perigoso/haptic-control/README.md

# haptic-control

PCB designed for (Someone else's) masters degree final project in eletrical-engineering

Made in the context of a research internship at IPL (Polytechnic Institute of Leiria)

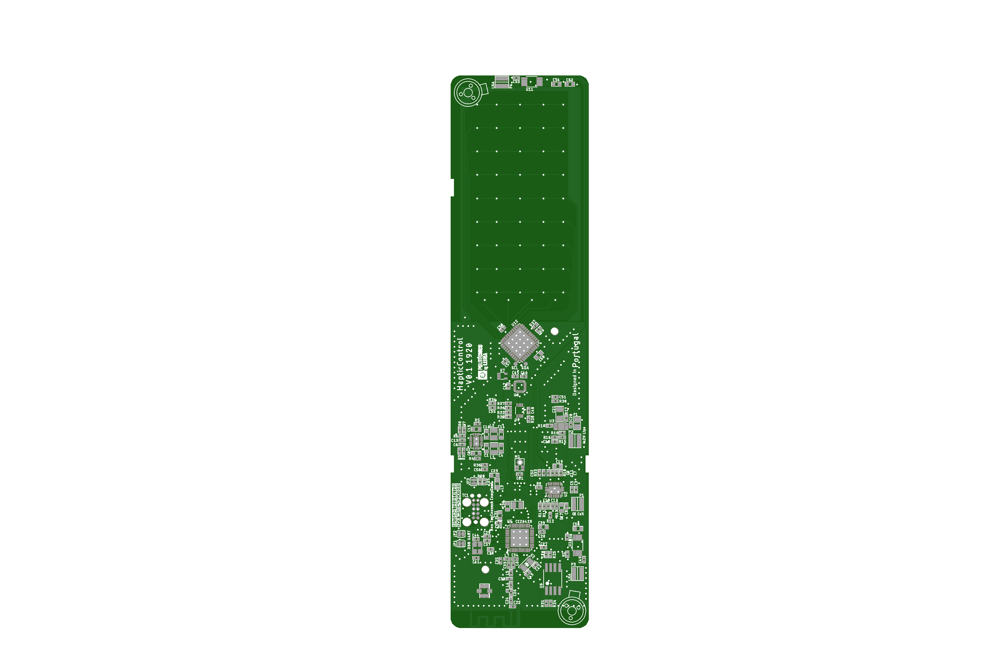
[picture p1: pcb/haptic-control-bot.png]


## Authors

- Rafael Silva
- João Silva
