perigoso/haptic-control/documentation/Screenshot_20190508_003053.png

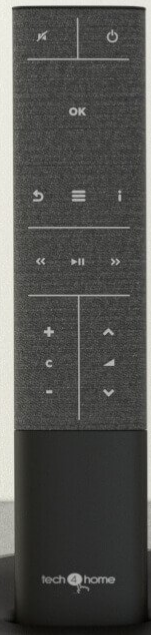
documentation/Screenshot_20190508_003053.png
