perigoso/haptic-control/pcb/haptic-control-top.png

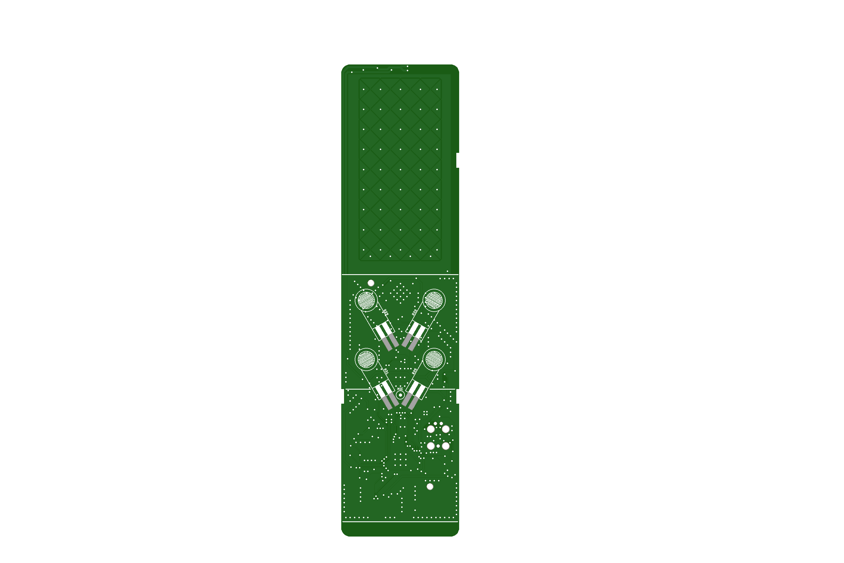
pcb/haptic-control-top.png
