perigoso/haptic-control/pcb/haptic-control-bom.xlsx

Sheet: Sheet1
Device | value | Package | Parts | Notes | Manufacturer | Sample Available | RoHS | REACH/SVHC | Lifecycle | Reference | Link | Qty / Board | Qty | Price(1) | Price(10) | Price(100) | Board price estimate(1) | Board price estimate(100) | Bom Price
capacitor | 100n | _0402 | C3, C20, C25, C27, C28, C29, C32, C37, C38, C40, C45, C46, C47, C48, C49, C53, C57, C58, C59, C61 | Decouple capacitors | Murata Electronics | n |  |  | Active | GCM155R71E104KE02D | https://eu.mouser.com/ProductDetail/Murata-Electronics/GCM155R71E104KE02D | 20 | 100 | 0.087 | 0.058 | 0.025 | 1.74 | 0.5 | 2.5
capacitor | 100u | _1206 | C21 | Bulk capacitor | Murata Electronics | n |  |  | Active | GRM31CD80J107ME39L | https://eu.mouser.com/ProductDetail/Murata-Electronics/GRM31CD80J107ME39L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 | 1 | 10 | 0.603 | 0.445 | 0.305 | 0.603 | 0.305 | 4.45
capacitor | 10n | _0402 | C7, C8 |  | Murata Electronics | n |  |  | Active | GCM155R71H103JA55J | https://eu.mouser.com/ProductDetail/Murata-Electronics/GCM155R71H103JA55J | 2 | 100 | 0.087 | 0.042 | 0.018 | 0.174 | 0.036 | 1.8
capacitor | 10u | _0603 | C60, C62 |  | Murata Electronics | n |  |  | Active | GRM188R60J106KE47D | https://eu.mouser.com/ProductDetail/Murata-Electronics/GRM188R60J106KE47D | 9 | 100 | 0.157 | 0.114 | 0.058 | 1.413 | 0.522 | 5.8
capacitor | 12p | _0402 | C35, C42, C43, C26 |  | Murata Electronics | n |  |  | Active | GCM1555C1H120JA16J | https://eu.mouser.com/ProductDetail/Murata-Electronics/GCM1555C1H120JA16J | 4 | 100 | 0.087 | 0.059 | 0.025 | 0.348 | 0.1 | 2.5
capacitor | 1n | _0402 | C5 |  | Murata Electronics | n |  |  | Active | GCM155R71H102JA37D | https://eu.mouser.com/ProductDetail/Murata-Electronics/GCM155R71H102JA37D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 | 1 | 100 | 0.087 | 0.039 | 0.017 | 0.087 | 0.017 | 1.7
capacitor | 1p | _0402 | C30, C33, C34 |  | Murata Electronics | n |  |  | Active | GCM1555C1H1R0JA16D | https://eu.mouser.com/ProductDetail/Murata-Electronics/GCM1555C1H1R0JA16D | 3 | 100 | 0.087 | 0.049 | 0.021 | 0.261 | 0.063 | 2.1
capacitor | 1p8 | _0402 | C24 |  | Murata Electronics | n |  |  | NRND | GRM1555C1E1R8BA01D | https://eu.mouser.com/ProductDetail/Murata-Electronics/\GRM1555C1E1R8BA01D?qs=sGAEpiMZZMs0AnBnWHyRQO3lCa4gsPOhwIirR49BN2M%3D | 1 | 100 | 0.087 | 0.056 | 0.024 | 0.087 | 0.024 | 2.4
capacitor | 1u | _0603 | C1, C16, C39, C50, C54 |  | Murata Electronics | n |  |  | NRND | GRM188R61A105MA61D | https://eu.mouser.com/ProductDetail/Murata-Electronics/GRM188R61A105MA61D | 5 | 100 | 0.096 | 0.065 | 0.027 | 0.48 | 0.135 | 2.7
capacitor | 22n | _0402 | C9, C10 |  | Murata Electronics | n |  |  | Active | GCM155R71E223JA55D | https://eu.mouser.com/ProductDetail/Murata-Electronics/GCM155R71E223JA55D | 2 | 100 | 0.087 | 0.049 | 0.021 | 0.174 | 0.042 | 2.1
capacitor | 22u | _0603 | C23, C31, C36 |  | Murata Electronics | n |  |  | Active | GRM188R60J226MEA0D | https://eu.mouser.com/ProductDetail/Murata-Electronics/GRM188R60J226MEA0D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 | 3 | 10 | 0.253 | 0.17 | 0.096 | 0.759 | 0.288 | 1.7
capacitor | 470n | _0402 | C11, C12 |  | Murata Electronics | n |  |  | NRND | GRM155R71A474KE01D | https://eu.mouser.com/ProductDetail/Murata-Electronics/GRM155R71A474KE01D | 2 | 100 | 0.087 | 0.071 | 0.031 | 0.174 | 0.062 | 3.1
capacitor | 470p | _0402 | C6, C13, C18, C51, C52, C55, C56 |  | Murata Electronics | n |  |  | Active | GCM155R71H471MA37D | https://eu.mouser.com/ProductDetail/Murata-Electronics/GCM155R71H471MA37D | 7 | 100 | 0.087 | 0.031 | 0.013 | 0.609 | 0.091 | 1.3
connector | ufl | _U.FL | A1 | U.FL | TE Connectivity | n |  |  | Active | 2337019-1 | https://eu.mouser.com/ProductDetail/TE-Connectivity/2337019-1 | 1 | 3 | 0.166 | 0.134 | 0.106 | 0.166 | 0.106 | 0.498
crystal | 32.768kHz | _3215 | X2 |  | Epson Timing | n |  |  |  | FC-135 32.7680KA-AG0 | https://eu.mouser.com/ProductDetail/Epson-Timing/FC-135-327680KA-AG0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 | 1 | 3 | 0.332 | 0.273 | 0.246 | 0.332 | 0.246 | 0.996
crystal | 48MHz | _3225 | X1 |  | Kyocera Electronic Components | n |  |  |  | CX2016DB48000C0FPLC1 | https://eu.mouser.com/ProductDetail/Kyocera-Electronic-Components/CX2016DB48000C0FPLC1 | 1 | 3 | 0.594 | 0.528 | 0.437 | 0.594 | 0.437 | 1.782
fsr | FSR400 | - | R29, R31, R33, R35 | FSR400-SHORT-TAIL | - | n |  |  | - | FSR400-SHORT-TAIL | - | 4 | 12 | - | - | -
inductor | 1u | _0806 | L1, L2 | Buck Inductors | Taiyo Yuden | n |  |  | Active | MAKK2016H1R0M | https://eu.mouser.com/ProductDetail/Taiyo-Yuden/MAKK2016H1R0M | 2 | 6 | 0.236 | 0.155 | 0.155 | 0.472 | 0.31 | 1.416
inductor | 2n | _0402 | L4, L5 | unshielded | TDK | n |  |  | Active | MLG1005S2N0CT000 | https://eu.mouser.com/ProductDetail/TDK/MLG1005S2N0CT000 | 2 | 6 | 0.087 | 0.038 | 0.034 | 0.174 | 0.068 | 0.522
inductor | 2n4 | _0402 | L6, L7 | unshielded | TDK | n |  |  | Active | MLG1005S2N4BT000 | https://eu.mouser.com/ProductDetail/TDK/MLG1005S2N4BT000 | 2 | 6 | 0.087 | 0.038 | 0.035 | 0.174 | 0.07 | 0.522
inductor | 6u8 | _0806 | L8 | MCU Core Buck Inductor | Taiyo Yuden | n |  |  | Active | BRC2016T6R8M | https://eu.mouser.com/ProductDetail/Taiyo-Yuden/BRC2016T6R8M | 1 | 3 | 0.271 | 0.182 | 0.151 | 0.271 | 0.151 | 0.813
filter | BLM18HE152SN1 | _0603 | L3 |  | Murata Electronics | n |  |  | Active | BLM18HE152SN1D | https://eu.mouser.com/ProductDetail/Murata-Electronics/BLM18HE152SN1D | 1 | 3 | 0.183 | 0.108 | 0.076 | 0.183 | 0.076 | 0.549
bat management | AP9211 | DFN2030-6 | U3 | battery prottection | Diodes Incorporated | n |  |  | Active | AP9211SA-AE-HAC-7 | https://eu.mouser.com/ProductDetail/Diodes-Incorporated/AP9211SA-AE-HAC-7 | 1 | 3 | 0.568 | 0.472 | 0.304 | 0.568 | 0.304 | 1.704
pptc | pptc | _0805 | F1 | 500mA trip current | Bel Fuse | n |  |  | Active | 0ZCK0020FF2G | https://eu.mouser.com/ProductDetail/Bel-Fuse/0ZCK0020FF2G | 1 | 3 | 0.122 | 0.117 | 0.081 | 0.122 | 0.081 | 0.366
resistor | 330 | _0402 | R17 | 5% | Yageo | n |  |  | Active | RC0402JR-13330RL | https://eu.mouser.com/ProductDetail/Yageo/RC0402JR-13330RL?qs=sGAEpiMZZMvdGkrng054tyXF6wqYTHOH6gUR5MIH6C8%3D | 1 | 100 | 0.087 | 0.009 | 0.003 | 0.087 | 0.003 | 0.3
resistor | 100k | _0402 | R1, R4, R5, R6, R10, R13, R15, R20, R21, R24, R25, R37, R38 | pull up resistors ( & vbat divider) 1% | Yageo | n |  |  | Active | RC0402FR-07100KL | https://eu.mouser.com/ProductDetail/Yageo/RC0402FR-07100KL?qs=sGAEpiMZZMvdGkrng054txdMlaQGj9fiWeFAEYA7478%3D | 13 | 100 | 0.087 | 0.01 | 0.003 | 1.131 | 0.039 | 0.3
resistor | 10M | _0402 | R19 | 5% | Yageo | n |  |  | Active | RC0402FR-0710ML | https://eu.mouser.com/ProductDetail/Yageo/RC0402FR-0710ML?qs=sGAEpiMZZMvdGkrng054t3wEnozbAaaSWWfsCSN2eSk%3D | 1 | 100 | 0.087 | 0.01 | 0.003 | 0.087 | 0.003 | 0.3
resistor | 10k | _0402 | R14 | QI Charger NTC bypass 5% | Yageo | n |  |  | Active | RC0402JR-7W10KL | https://eu.mouser.com/ProductDetail/Yageo/RC0402JR-7W10KL | 1 | 100 | 0.087 | 0.01 | 0.003 | 0.087 | 0.003 | 0.3
resistor | 140 | _0402 | R12 | 1% | Yageo | n |  |  | Active | RC0402FR-07140RL | https://eu.mouser.com/ProductDetail/Yageo/RC0402FR-07140RL?qs=sGAEpiMZZMvdGkrng054t8AJgcdMkx7xLGg9K55Kjt4%3D | 1 | 100 | 0.087 | 0.01 | 0.003 | 0.087 | 0.003 | 0.3
resistor | 158k | _0402 | R8 | 1% | Yageo | n |  |  | Active | RC0402FR-07158KL | https://eu.mouser.com/ProductDetail/Yageo/RC0402FR-07158KL | 1 | 100 | 0.087 | 0.01 | 0.003 | 0.087 | 0.003 | 0.3
resistor | 2k7 | _0402 | R18 | 1% | Yageo | n |  |  | Active | RC0402FR-072K7L | https://eu.mouser.com/ProductDetail/Yageo/RC0402FR-072K7L?qs=sGAEpiMZZMvdGkrng054t8AJgcdMkx7xEULkXzel7Wo%3D | 1 | 100 | 0.087 | 0.01 | 0.003 | 0.087 | 0.003 | 0.3
resistor | 1k2 | _0402 | R11 | 1% | Yageo | n |  |  | Active | AC0402FR-071K2L | https://eu.mouser.com/ProductDetail/Yageo/AC0402FR-071K2L?qs=sGAEpiMZZMvdGkrng054t1dXgLbs7QPXYJaSyzoIyoA%3D | 1 | 100 | 0.087 | 0.01 | 0.003 | 0.087 | 0.003 | 0.3
resistor | 200k | _0402 | R28 | 5% | Yageo | n |  |  | Active | RC0402FR-07200KL | https://eu.mouser.com/ProductDetail/Yageo/RC0402FR-07200KL | 1 | 100 | 0.087 | 0.01 | 0.003 | 0.087 | 0.003 | 0.3
resistor | 2k43 | _0402 | R9 | 1% | Yageo | n |  |  | Active | RC0402FR-072K43L | https://eu.mouser.com/ProductDetail/Yageo/RC0402FR-072K43L?qs=sGAEpiMZZMvdGkrng054txdMlaQGj9fiVaCQFdFcUTs%3D | 1 | 100 | 0.087 | 0.01 | 0.003 | 0.087 | 0.003 | 0.3
resistor | 3k4 | _0402 | R30, R32, R34, R36 | 1% | Yageo | n |  |  | Active | RC0402FR-073K4L | https://eu.mouser.com/ProductDetail/Yageo/RC0402FR-073K4L?qs=sGAEpiMZZMvdGkrng054t8AJgcdMkx7xgpEjmeLAGq8%3D | 4 | 100 | 0.087 | 0.01 | 0.003 | 0.348 | 0.012 | 0.3
resistor | 301k | _0402 | R7 | 1% | Yageo | n |  |  | Active | RC0402FR-07301KL | https://eu.mouser.com/ProductDetail/Yageo/RC0402FR-07301KL | 1 | 100 | 0.087 | 0.01 | 0.003 | 0.087 | 0.003 | 0.3
resistor | 309k | _0402 | R2 | 1% | Yageo | n |  |  | Active | RC0402FR-07309KL | https://eu.mouser.com/ProductDetail/Yageo/RC0402FR-07309KL | 1 | 100 | 0.087 | 0.01 | 0.003 | 0.087 | 0.003 | 0.3
resistor | 49k9 | _0402 | R16 | 1% | Yageo | n |  |  | Active | RC0402FR-0749K9L | https://eu.mouser.com/ProductDetail/Yageo/RC0402FR-0749K9L | 1 | 100 | 0.087 | 0.01 | 0.003 | 0.087 | 0.003 | 0.3
resistor | 4k7 | _0402 | R22, R23, R26, R27 | i2C pullups 5% | Yageo | n |  |  | Active | RC0402JR-074K7L | https://eu.mouser.com/ProductDetail/Yageo/RC0402JR-074K7L | 4 | 100 | 0.087 | 0.01 | 0.003 | 0.348 | 0.012 | 0.3
resistor | 71k5 | _0402 | R3 | 1% | Yageo | n |  |  | Active | RC0402FR-0771K5L | https://eu.mouser.com/ProductDetail/Yageo/RC0402FR-0771K5L?qs=sGAEpiMZZMvdGkrng054t8AJgcdMkx7xnOhPQVwMv9Y%3D | 1 | 100 | 0.087 | 0.01 | 0.003 | 0.087 | 0.003 | 0.3
touch controller | MTCH6301 | QFN44 | U12 | touch matrix controller | Microchip Technology | y |  |  | Active | MTCH6301-I/ML | https://eu.mouser.com/ProductDetail/Microchip-Technology/MTCH6301-I-ML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 | 1 | 3 | 2.51 | 2.47 | 2.08 | 2.51 | 2.08 | 7.53
qi charger ic | BQ51050B | VQFN20 | U2 |  | Texas Instruments | n |  |  | Active | BQ51050BRHLR | https://eu.mouser.com/ProductDetail/Texas-Instruments/BQ51050BRHLR | 1 | 0 | 3.26 | 2.93 | 2.39 | 3.26 | 2.39 | 0
mpu | ICM20948 | QFN20 | U8 |  | TDK InvenSense | n |  |  | Active | ICM-20948 | https://eu.mouser.com/ProductDetail/TDK-InvenSense/ICM-20948 | 1 | 3 | 6.65 | 5.41 | 3.3 | 6.65 | 3.3 | 19.95
mcu | CC2642R | QFN48 | U5 |  | Texas Instruments | n |  |  | Active | CC2642R1FRGZR | https://eu.mouser.com/ProductDetail/Texas-Instruments/CC2642R1FRGZT | 1 | 0 | 5.62 | 5.08 | 4.2 | 5.62 | 4.2 | 0
logic gate | 74LVC1G17 | SC70-5 | U7 |  | Nexperia | n |  |  | Active | 74LVC1G17GV | https://eu.mouser.com/ProductDetail/Nexperia/74LVC1G17GV125?qs=sGAEpiMZZMutXGli8Ay4kDE4J8KCiPsFe3SZlXnQs3A%3D | 1 | 3 | 0.253 | 0.175 | 0.073 | 0.253 | 0.073 | 0.759
microphone | SPH0641LM4H-1 | - | M1 | SPH0641LM4H-1 | Knowles | n |  |  | Active | SPH0641LM4H-1 | https://eu.mouser.com/ProductDetail/Knowles/SPH0641LM4H-1 | 1 | 3 | 0.996 | 0.789 | 0.625 | 0.996 | 0.625 | 2.988
i2c level translator | PCA9306 | VSSOP8 | U9 | PCA9306-DCU | Texas Instruments | n |  |  | Active | PCA9306DCUR | https://eu.mouser.com/ProductDetail/Texas-Instruments/PCA9306DCUR | 1 | 0 | 0.576 | 0.477 | 0.307 | 0.576 | 0.307 | 0
driver | DRV2605L | VSSOP10 | U10, U11 |  | Texas Instruments | n |  |  | Active | DRV2605LYZFR | https://eu.mouser.com/ProductDetail/Texas-Instruments/DRV2605LYZFR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 | 2 | 6 | 2.54 | 2.29 | 1.87 | 5.08 | 3.74 | 15.24
buck | MIC23159 | VQFN20 | U1 |  | Microchip Technology / Micrel | y |  |  | Active | MIC23158YML-T5 | https://eu.mouser.com/ProductDetail/Microchip-Technology-Micrel/MIC23158YML-T5 | 1 | 3 | 1.94 | 1.91 | 1.47 | 1.94 | 1.47 | 5.82
flash | 8Mbit | WSOIC8 | U6 |  | Winbond |  |  |  | Active | W25Q80DVSSIG | https://eu.mouser.com/ProductDetail/Winbond/W25Q80DVSSIG | 1 | 3 | 0.367 | 0.362 | 0.298 | 0.367 | 0.298 | 1.101
 |  |  |  |  |  |  |  |  |  |  |  |  |  |  |  |  | Total: | Total: | Total:
 |  |  |  |  |  |  |  |  |  |  |  |  |  |  |  |  | 40.175 | 22.619 | 101.506
 |  |  |  |  |  | y

Sheet: Sheet2
Device | value | Package | Parts
capacitor | 100n | _0402 | C3, C20, C25, C27, C28, C29, C32, C37, C38, C40, C45, C46, C47, C48, C49, C53, C57, C58, C59, C61
capacitor | 100u | _1206 | C21
capacitor | 10n | _0402 | C7, C8
capacitor | 10u | _0603 | C60, C62
capacitor | 12p | _0402 | C35, C42, C43, C26
capacitor | 1n | _0402 | C5
capacitor | 1p | _0402 | C30, C33, C34
capacitor | 1p8 | _0402 | C24
capacitor | 1u | _0603 | C1, C16, C39, C50, C54
capacitor | 22n | _0402 | C9, C10
capacitor | 22u | _0603 | C23, C31, C36
capacitor | 470n | _0402 | C11, C12
capacitor | 470p | _0402 | C6, C13, C18, C51, C52, C55, C56
connector | ufl | _U.FL | A1
crystal | 32.768kHz | _3215 | X2
crystal | 48MHz | _3225 | X1
fsr | FSR400 | - | R29, R31, R33, R35
inductor | 1u | _0806 | L1, L2
inductor | 2n | _0402 | L4, L5
inductor | 2n4 | _0402 | L6, L7
inductor | 6u8 | _0806 | L8
filter | BLM18HE152SN1 | _0603 | L3
bat management | AP9211 | DFN2030-6 | U3
pptc | pptc | _0805 | F1
resistor | 330 | _0402 | R17
resistor | 100k | _0402 | R1, R4, R5, R6, R10, R13, R15, R20, R21, R24, R25, R37, R38
resistor | 10M | _0402 | R19
resistor | 10k | _0402 | R14
resistor | 140 | _0402 | R12
resistor | 158k | _0402 | R8
resistor | 2k7 | _0402 | R18
resistor | 1k2 | _0402 | R11
resistor | 200k | _0402 | R28
resistor | 2k43 | _0402 | R9
resistor | 3k4 | _0402 | R30, R32, R34, R36
resistor | 301k | _0402 | R7
resistor | 309k | _0402 | R2
resistor | 49k9 | _0402 | R16
resistor | 4k7 | _0402 | R22, R23, R26, R27
resistor | 71k5 | _0402 | R3
touch controller | MTCH6301 | QFN44 | U12
qi charger ic | BQ51050B | VQFN20 | U2
mpu | ICM20948 | QFN20 | U8
mcu | CC2642R | QFN48 | U5
logic gate | 74LVC1G17 | SC70-5 | U7
microphone | SPH0641LM4H-1 | - | M1
i2c level translator | PCA9306 | VSSOP8 | U9
driver | DRV2605L | VSSOP10 | U10, U11
buck | MIC23159 | VQFN20 | U1
flash | 8Mbit | WSOIC8 | U6
