perigoso/haptic-control/documentation/WCS037B/BOM/WCS037B_BOM.xlsx

Design Modify Date = Tuesday, July 10, 2018
RevCode = B
Title = LAUNCHXL-CC26X2R1
Part Number | Quantity | Part Reference | Value | Description | Vendor | Vendor Part Number | ROHS | REACH/SVHC Compliance
02-07617 | 8 | C1 C9 C14 C17 C18 C31 C88 C89 | 12pF | CAPACITOR, CERAMIC C0G/NP0, 12pF, 50V, -5%/+5%, -55DEGC/+125DEGC, 0402, SMD | MURATA | GRM1555C1H120JA01D | Compliant | Compliant
02-07775 | 8 | C2 C3 C4 C7 C50 C109 C166 C484 | 10nF | CAPACITOR, CERAMIC X7R, 10nF, 25V, -10%/+10%, -55DEGC/+125DEGC, 0402, SMD | MURATA | GRM155R71E103KA01D | Compliant | Compliant
02-06085 | 7 | C6 C78 C79 C80 C83 C84 C87 | 100nF | CAPACITOR, CERAMIC X5R, 100nF, 10V, -10%/+10%, -55DEGC/+85DEGC, 0201, SMD | MURATA | GRM033R61A104KE84D | Compliant | Compliant
02-07861 | 40 | C8 C20 C30 C38 C39 C43 C46 C70 C71 C72 C73 C74 C75 C99 C101 C102 C104 C106 C107 C110 C114 C115 C116 C118 C119 C120 C125 C126 C127 C139 C140 C141 C152 C154 C158 C161 C162 C164 C175 C485 | 0.1uF | CAPACITOR, CERAMIC X7R, 0.1uF, 25V, -10%/+10%, -55DEGC/+125DEGC, 0402, SMD | MURATA | GRM155R71E104KE14D | Compliant | Compliant
02-07627 | 3 | C11 C13 C21 | 1pF | CAPACITOR, CERAMIC C0G/NP0, 1pF, 50V, -0.25pF/ +0.25pF, -55DEGC/+125DEGC, 0402, SMD | MURATA | GRM1555C1H1R0CA01D | Compliant | Compliant
02-07620 | 1 | C12 | 1.8pF | CAPACITOR, CERAMIC C0G/NP0, 1.8pF, 50V, -0.25pF, +0.25pF, -55DEGC/+125DEGC, 0402, SMD | MURATA | GRM1555C1H1R8CA01D | Compliant | Compliant
DNM | 0 | C15 C24 | DNM | DNM | DNM | DNM | DNM
02-07863 | 10 | C19 C40 C42 C44 C128 C133 C136 C137 C138 C145 | 1uF | CAPACITOR, CERAMIC X5R, 1uF, 16V, -10%/+10%, -55DEGC/+85DEGC, 0402, SMD | MURATA | GRM155R61C105KA12D | Compliant | Compliant
02-06058 | 13 | C45 C48 C49 C143 C144 C149 C151 C155 C157 C159 C160 C163 C171 | 2.2uF | CAPACITOR, CERAMIC X5R, 2.2uF, 25V, -10%/+10%, -55DEGC/+85DEGC, 0402, SMD | MURATA | GRM155R61E225KE11D | Compliant | Compliant
02-07776 | 3 | C47 C153 C172 | 15pF | CAPACITOR, CERAMIC C0G/NP0, 15pF, 50V, -5%/+5%, -55DEGC/+125DEGC, 0402, SMD | MURATA | GRM1555C1H150JA01D | Compliant | Compliant
02-07629 | 2 | C85 C86 | 4.7uF | CAPACITOR, CERAMIC X5R, 4.7uF, 6.3V, -20%/+20%, -55DEGC/+85DEGC, 0402, SMD | MURATA | GRM155R60J475ME87D | Compliant | Compliant
02-07053 | 6 | C103 C105 C113 C156 C165 C174 | 22uF | CAPACITOR, CERAMIC, X5R, 22uF, 6.3V, -20%/+20%, -55DEGC/+85DEGC, 0603, SMD | MURATA | GRM188R60J226MEA0D | Compliant | Compliant
02-04479 | 1 | C108 | 33nF | CAPACITOR, CERAMIC X7R, 33nF, 25V, -10%/+10%, -55DEGC/+125DEGC, 0402, SMD | MURATA | GRM155R71E333KA88D | Compliant
02-05897 | 1 | C111 | 3.3uF | CAPACITOR, CERAMIC X5R, 3.3uF, 10V, -10%/+10%, -55DEGC/+85DEGC, 0603, SMD | MURATA | GRM188R61A335KE15D | Compliant | Compliant
02-04936 | 1 | C112 | 220uF | CAPACITOR, TANTALUM, 220uF, 10V, -10%/+10%, -55DEGC/+125DEGC, 7343-20, SMD | AVX | TPSY227K010R0100 | Compliant
02-05775 | 6 | C117 C121 C122 C142 C147 C168 | 10uF | CAPACITOR, CERAMIC X7R, 10uF, 16V, -10%/+10%, -55DEGC/+125DEGC, 0805, SMD | SAMSUNG ELECTRO-MECHANICS | CL21B106KOQNNNE | Compliant | Compliant
02-08708 | 2 | C123 C135 | 270pF | CAPACITOR, CERAMIC C0G/NP0, 270pF, 50V, -1%/+1%, -55DEGC/+125DEGC, 0402, SMD | MURATA | GRM1555C1H271FA01D | Compliant | Compliant
DNM | 0 | C124 C132 C134 C170 | DNM | DNM | DNM | DNM | DNM | DNM
02-00613 | 1 | C129 | 470pF | CAPACITOR, CERAMIC X7R, 470pF, 50V, -10%/+10%, -55DEGC/+125DEGC, 0402, SMD | MURATA | GRM155R71H471KA01D | Compliant | Compliant
02-02070 | 1 | C130 | 1nF | CAPACITOR, CERAMIC X7R, 1nF, 50V, -10%/+10%, -55DEGC/+125DEGC, 0402, SMD | MURATA | GRM155R71H102KA01D | Compliant | Compliant
02-05294 | 1 | C131 | 22nF | CAPACITOR, CERAMIC X7R, 22nF, 25V, -10%/+10%, -55DEGC/+125DEGC, 0402, SMD | MURATA | GRM155R71E223KA61D | Compliant | Compliant
02-07728 | 1 | C146 | 47uF | CAPACITOR, CERAMIC X5R, 47uF, 10V, -20%/+20%, -55DEGC/+85DEGC, 0805, SMD | MURATA | GRM21BR61A476ME15L | Compliant | Compliant
DNM | 0 | C169 | DNM | DNM | DNM | DNM | DNM | DNM
02-08923 | 1 | C486 | 220uF | CAPACITOR, CERAMIC X5R, 220uF, 6.3V, -20%/+20%, -55DEGC/+85DEGC, 1210, SMD | MURATA | GRM32ER60J227ME05L | Compliant | Compliant
15-01023 | 2 | CR1 CR5 | LPL296-J2L2-25 | OPTO, LED, GREEN COLOR, 562nm, 0.02A, 0.08W, 0603, SMD | OSRAM | LP L296-J2L2-25 | Compliant | Compliant
15-01169 | 2 | CR2 CR4 | LS L296-P2Q2-1 | OPTO, LED, SUPER RED COLOR, 630nm, 1.8V TO 2.3V, 0.06A, 0603, SMD | OSRAM | LS L296-P2Q2-1 | Compliant | Compliant
14-06172 | 1 | CR6 | TPD4E004DRY | DIODE, PROTECTION, ESD ARRAY, 4 CHANNEL, 6V TO 8V, -40DEGC/+85DEGC, SON6, SMD | TEXAS INSTRUMENTS | TPD4E004DRYR | Compliant | Compliant
14-05493 | 2 | CR7 CR8 | TPD6E004RSER | DIODE, PROTECTION, ESD ARRAY - 6 CHANNELS, 7V, -40DEGC/+85DEGC, QFN8, SMD | TEXAS INSTRUMENTS | TPD6E004RSER | Compliant | Compliant
DNM | 0 | CR14 | DNM | DNM | DNM | DNM | DNM | DNM
14-03076 | 1 | CR15 | MBR130T1 | DIODE, SCHOTTKY, 1A, 30V, -65DEGC/+125DEGC, SOD-123, SMD | ON SEMICONDUCTOR | MBR130T1G | Compliant
04-00470 | 4 | FL1 FL2 FL4 FL5 | BLM18HE152SN1 | FILTER, EMI, FERRITE BEAD, 1500@100MHz, -25%/+25%, -55DEGC/+125DEGC, 0603, SMD | MURATA | BLM18HE152SN1D | Compliant | Compliant
06-04997 | 2 | J1 J2 | SSQ-110-23-L-D | CONNECTOR, HEADER, FEMALE, STRAIGHT, 2 ROWS, 20 ROWS, 2.54mm, PTH | SAMTEC | SSQ-110-23-L-D | Compliant | Compliant
06-04998 | 1 | J6 | 105164-0001 | CONNECTOR, USB, FEMALE, RIGHT ANGLE, 1 ROW, 5 PINS, PITCH 0.65mm, SMD | MOLEX | 105164-0001 | Compliant | Compliant
03-07266 | 1 | L1 | 6.8uH | INDUCTOR, STANDARD, CHIP, FERRITE CORE, SHIELDED, 6.8uH, -20%/+20%, 1.1A, -55DEGC/+125DEGC, 0805, SMD | TDK | MLZ2012N6R8LT000 | Compliant | Compliant
03-07526 | 2 | L11 L21 | 2.4nH | INDUCTOR, RF, CHIP, NON-MAGNETIC CORE, 2.4nH, -0.3nH/+0.3nH, 0.3A, -55DEGC/+125DEGC, 0402, SMD | MURATA | LQG15HS2N4S02D | Compliant | Compliant
03-07527 | 2 | L12 L13 | 2nH | INDUCTOR, RF, CHIP, NON-MAGNETIC CORE, 2nH, -0.3nH/+0.3nH, 0.3A, -55DEGC/+125DEGC, 0402, SMD | MURATA | LQG15HS2N0S02D | Compliant | Compliant
04-00050 | 3 | L332 L333 L334 | BLM21PG221SN1 | FILTER, EMI, FERRITE BEAD, 220@100MHz, -25%/+25%, -55DEGC/+125DEGC, 0805, SMD | MURATA | BLM21PG221SN1D | Compliant | Compliant
 | 1 | LBL1 | LP_STICKER
19-00498 | 11 | M1 M2 M3 M4 M5 M6 M7 M8 M9 M10 M14 | SNT-100-BK-G | MECHANIC, SHUNT, CURRENT RATING 4.3A PER PIN, 2.54 X 5.08 X 6.1mm, BLACK | SAMTEC | SNT-100-BK-G | Compliant | Compliant
DNM | 0 | M11 M12 M13 | DNM | DNM | DNM | DNM | DNM | DNM
13-04664 | 4 | M15 M16 M17 M18 | DCB-10 | MECHANIC, ACCESSORY, SPACER SUPPORT, PCB DIA. 3mm, NYLON 66, PTH | SUZHOU SOLY ELECTRICIAN | DCB-10 | Compliant | Compliant
06-05038 | 3 | P1 P2 P10 | BB02-HC031-KB1-603000 | CONNECTOR, HEADER, MALE, STRAIGHT, 1 ROW, 3 PINS, PITCH 2.54mm, PTH | GRADCONN | BB02-HC031-KB1-603000 | Compliant | Compliant
06-05049 | 1 | P4 | BB02-HJ221-KB1-603000 | CONNECTOR, HEADER, MALE, STRAIGHT, 2 ROWS, 22 PINS, PITCH 2.54mm, PTH | GRADCONN | BB02-HJ221-KB1-603000 | Compliant | Compliant
06-00166 | 2 | P5 P7 | FTSH-105-01-F-DV-K | CONNECTOR, HEADER, MALE, STRAIGHT, 2 ROWS, 10 PINS, PITCH 1.27mm, SMD | SAMTEC | FTSH-105-01-F-DV-K | Compliant | Compliant
06-04999 | 1 | P6 | BB02-HJ041-KB1-603000 | CONNECTOR, HEADER, MALE, STRAIGHT, 2 ROWS, 4 PINS, PITCH 2.54mm, PTH | GRADCONN | BB02-HJ041-KB1-603000 | Compliant | Compliant
DNM | 0 | P8 | DNM | DNM | DNM | DNM | DNM
06-05051 | 1 | P11 | MM5829-2700 | CONNECTOR, COAX, MALE, UP TO 12GHz, 30V, SMD | MURATA | MM5829-2700RJ4 | Compliant | Compliant
19-00925 | 1 | PCB1 | MCU039 | NON COMPONENT, PCB, TEXAS INSTRUMENTS | TEXAS INSTRUMENTS | PCB | Missing Info
01-22492 | 9 | R1 R96 R97 R98 R105 R117 R118 R119 R136 | 100k | RESISTOR, THICK FILM, 100k, -5%/+5%, 0.063W, 50V, -55DEGC/+155DEGC, 0402, SMD | VISHAY | CRCW0402100KJNED | Exempt | Compliant
DNM | 0 | R2 R3 R59 R60 | DNM | DNM | DNM | DNM | DNM | DNM
01-22487 | 1 | R11 | 2.2k | RESISTOR, THICK FILM, 2.2k, -5%/+5%, 0.063W, 50V, -55DEGC/+155DEGC, 0402, SMD | VISHAY | CRCW04022K20JNED | Exempt | Compliant
01-22346 | 2 | R14 R25 | 220 | RESISTOR, THICK FILM, 220, -5%/+5%, 0.063W, 50V, -55DEGC/+155DEGC, 0402, SMD | VISHAY | CRCW0402220RJNED | Exempt | Compliant
01-22345 | 2 | R15 R23 | 180 | RESISTOR, THICK FILM, 180, -5%/+5%, 0.063W, 50V, -55DEGC/+155DEGC, 0402, SMD | VISHAY | CRCW0402180RJNED | Exempt | Compliant
01-22353 | 1 | R17 | 10k | RESISTOR, THICK FILM, 10k, -5%/+5%, 0.063W, 50V, -55DEGC/+155DEGC, 0402, SMD | VISHAY | CRCW040210K0JNED | Exempt | Compliant
01-22489 | 3 | R18 R126 R353 | 4.7k | RESISTOR, THICK FILM, 4.7k, -5%/+5%, 0.063W, 50V, -55DEGC/+155DEGC, 0402, SMD | VISHAY | CRCW04024K70JNED | Exempt | Compliant
01-22482 | 4 | R20 R55 R56 R57 | 100 | RESISTOR, THICK FILM, 100, -5%/+5%, 0.063W, 50V, -55DEGC/+155DEGC, 0402, SMD | VISHAY | CRCW0402100RJNED | Exempt | Compliant
DNM | 0 | R21 | DNM | DNM | DNM | DNM | DNM | DNM
01-22486 | 4 | R27 R29 R30 R39 | 1k | RESISTOR, THICK FILM, 1k, -5%/+5%, 0.063W, 50V, -55DEGC/+155DEGC, 0402, SMD | VISHAY | CRCW04021K00JNED | Exempt | Compliant
01-22494 | 1 | R28 | 4.87k | RESISTOR, THICK FILM, 4.87k, -1%/+1%, 0.063W, 50V, -55DEGC/+155DEGC, 0402, SMD | VISHAY | CRCW04024K87FKED | Exempt | Compliant
01-22481 | 1 | R31 | 51 | RESISTOR, THICK FILM, 51, -5%/+5%, 0.063W, 50V, -55DEGC/+155DEGC, 0402, SMD | VISHAY | CRCW040251R0JNED | Exempt | Compliant
01-22477 | 1 | R32 | 33k | RESISTOR, THICK FILM, 33k, -1%/+1%, 0.063W, 50V, -55DEGC/+155DEGC, 0402, SMD | VISHAY | CRCW040233K0FKED | Exempt | Compliant
01-22491 | 3 | R33 R132 R151 | 51k | RESISTOR, THICK FILM, 51k, -5%/+5%, 0.063W, 50V, -55DEGC/+155DEGC, 0402, SMD | VISHAY | CRCW040251K0JNED | Exempt | Compliant
01-22490 | 4 | R34 R133 R135 R152 | 30k | RESISTOR, THICK FILM, 30k, -5%/+5%, 0.063W, 50V, -55DEGC/+155DEGC, 0402, SMD | VISHAY | CRCW040230K0JNED | Exempt | Compliant
DNM | 0 | R46 R47 R52 | DNM | DNM | DNM | DNM | DNM | DNM
01-20043 | 4 | R48 R49 R51 R89 | 0 | RESISTOR, THICK FILM, 0, 0R/+0.02R, 0.1W, 75V, -55DEGC/+155DEGC, 0603, SMD | VISHAY | CRCW06030000Z0EC | Exempt | Compliant
01-22488 | 1 | R58 | 3.3k | RESISTOR, THICK FILM, 3.3k, -5%/+5%, 0.063W, 50V, -55DEGC/+155DEGC, 0402, SMD | VISHAY | CRCW04023K30JNED | Exempt | Compliant
01-22536 | 5 | R61 R62 R63 R65 R114 | 100k | RESISTOR, THICK FILM, 100k, -1%/+1%, 0.063W, 50V, -55DEGC/+155DEGC, 0402, SMD | TT ELECTRONICS | WCR0402-100KFA | Exempt | Compliant
01-04196 | 3 | R82 R83 R92 | 10k | RESISTOR, THICK FILM, 10k, -5%/+5%, 0.05W, 30V, -55DEGC/+155DEGC, 0201, SMD | VISHAY | CRCW020110K0JNED | Exempt | Compliant
01-04087 | 1 | R84 | 12k | RESISTOR, THICK FILM, 12k, -1%/+1%, 0.05W, 30V, -55DEGC/+155DEGC, 0201, SMD | VISHAY | CRCW020112K0FKED | Exempt | Compliant
01-22476 | 1 | R87 | 1Meg | RESISTOR, THICK FILM, 1M, -1%/+1%, 0.063W, 50V, -55DEGC/+155DEGC, 0402, SMD | VISHAY | CRCW04021M00FKED | Exempt | Compliant
01-04172 | 2 | R90 R91 | 1k | RESISTOR, THICK FILM, 1k, -5%/+5%, 0.05W, 30V, -55DEGC/+155DEGC, 0201, SMD | VISHAY | CRCW02011K00JNED | Exempt | Compliant
01-04203 | 1 | R93 | 20k | RESISTOR, THICK FILM, 20k, -5%/+5%, 0.05W, 30V, -55DEGC/+155DEGC, 0201, SMD | VISHAY | CRCW020120K0JNED | Exempt | Compliant
01-01183 | 1 | R94 | 22 | RESISTOR, THICK FILM, 22, -5%/+5%, 0.063W, 50V, -55DEGC/+155DEGC, 0402, SMD | VISHAY | CRCW040222R0JNED | Exempt | Compliant
01-00128 | 4 | R95 R101 R109 R120 | 1.2k | RESISTOR, THICK FILM, 1.2k, -1%/+1%, 0.063W, 50V, -55DEGC/+155DEGC, 0402, SMD | VISHAY | CRCW04021K20FKED | Exempt | Compliant
01-22495 | 4 | R99 R100 R108 R131 | 0 | RESISTOR, THICK FILM, 0, 0.063W, 50V, -55DEGC/+155DEGC, 0402, SMD | VISHAY | CRCW04020000Z0ED | Exempt | Compliant
01-00195 | 2 | R102 R110 | 330 | RESISTOR, THICK FILM, 330, -1%/+1%, 0.063W, 50V, -55DEGC/+155DEGC, 0402, SMD | VISHAY | CRCW0402330RFKED | Exempt | Compliant
01-04307 | 2 | R103 R112 | 4.99 | RESISTOR, THICK FILM, 4.99, -1%/+1%, 0.063W, 50V, -55DEGC/+155DEGC, 0402, SMD | VISHAY | CRCW04024R99FKED | Exempt | Compliant
01-00234 | 3 | R104 R113 R354 | 10 | RESISTOR, THICK FILM, 10, -1%/+1%, 0.063W, 50V, -55DEGC/+155DEGC, 0402, SMD | VISHAY | CRCW040210R0FKED | Exempt | Compliant
DNM | 0 | R106 R111 | DNM | DNM | DNM | DNM | DNM | DNM
01-03527 | 1 | R107 | 1 | RESISTOR, THICK FILM, 1, -1%/+1%, 1W, 200V, -55DEGC/+155DEGC, 1218, SMD | VISHAY | CRCW12181R00FNEK | Exempt | Compliant
DNM | 0 | R115 | DNM | DNM | DNM | DNM | DNM | DNM
01-04658 | 2 | R116 R134 | 60.4k | RESISTOR, THICK FILM, 60.4k, -1%/+1%, 0.063W, 50V, -55DEGC/+155DEGC, 0402, SMD | VISHAY | CRCW040260K4FKED | Exempt | Compliant
01-01252 | 1 | R121 | 22k | RESISTOR, THICK FILM, 22k, -5%/+5%, 0.063W, 50V, -55DEGC/+155DEGC, 0402, SMD | VISHAY | CRCW040222K0JNED | Exempt | Compliant
01-20687 | 1 | R122 | 0.22 | RESISTOR, THICK FILM, 0.22, -1%/+1%, 0.125W, -55DEGC/+155DEGC, 0402, SMD | VISHAY | RCWE0402R220FKEA | Exempt | Compliant
01-06917 | 1 | R123 | 82 | RESISTOR, THICK FILM, 82, -1%/+1%, 0.25W, 200V, -55DEGC/+155DEGC, 1206, SMD | VISHAY | CRCW120682R0FKEA | Exempt | Compliant
01-07315 | 1 | R125 | 36.5 | RESISTOR, THICK FILM, 36.5, -1%/+1%, 0.5W, 200V, -55DEGC/+155DEGC, 1210, SMD | VISHAY | CRCW121036R5FKEA | Exempt | Compliant
01-01260 | 3 | R127 R128 R129 | 47k | RESISTOR, THICK FILM, 47k, -5%/+5%, 0.063W, 50V, -55DEGC/+155DEGC, 0402, SMD | VISHAY | CRCW040247K0JNED | Exempt | Compliant
01-00239 | 1 | R130 | 2.2k | RESISTOR, THICK FILM, 2.2k, -1%/+1%, 0.063W, 50V, -55DEGC/+155DEGC, 0402, SMD | VISHAY | CRCW04022K20FKED | Exempt | Compliant
01-04542 | 1 | R137 | 2.61k | RESISTOR, THICK FILM, 2.61k, -1%/+1%, 0.063W, 50V, -55DEGC/+155DEGC, 0402, SMD | VISHAY | CRCW04022K61FKED | Exempt | Compliant
DNM | 0 | R138 | DNM | DNM | DNM | DNM | DNM | DNM
01-04141 | 9 | R140 R141 R142 R143 R144 R145 R146 R147 R148 | 51 | RESISTOR, THICK FILM, 51, -5%/+5%, 0.05W, 30V, -55DEGC/+155DEGC, 0201, SMD | VISHAY | CRCW020151R0JNED | Exempt | Compliant
08-00293 | 3 | SW1 SW2 SW3 | 1188E-1K2-V | SWITCH, TACT, 0.05A@250VAC, 0.05A@12VDC, 0.05A, 250V, SMD | DIPTRONICS | 1188E-1K2-V-TR | Compliant | Compliant
18-33872 | 1 | U1 | CC2652R1FRGZ | IC, CUSTOM, CC2652R1FRGZ, QFN48-EP, SMD | TEXAS INSTRUMENTS | CC2652R1FRGZ | Missing Info | Missing Info
18-31726 | 1 | U4 | MX25R8035FZUIL0 | IC, MEMORY, FLASH, SERIAL, 8Mbit, 1.65V TO 3.6V, USON8, SMD | MACRONIX | MX25R8035FZUIL0 | Compliant | Compliant
18-29558 | 1 | U6 | LM4040B25IDCK | IC, ANALOG, PRECISION MICROPOWER SHUNT VOLTAGE REFERENCE, 2.5V, SC70-5, SMD | TEXAS INSTRUMENTS | LM4040B25IDCKR | Compliant | Compliant
18-29530 | 3 | U7 U42 U46 | TPS79601DR | IC, ANALOG, ULTRALOW-NOISE, HIGH PSRR, FAST, RF, 1A LOW-DROPOUT LINEAR REGULATORS, VIN:2.7V TO 5.5V, VOUT:1.2V TO 5.5V, SON8, SMD | TEXAS INSTRUMENTS | TPS79601DRBR | Compliant | Compliant
18-29288 | 3 | U8 U9 U10 | SN74AVC4T245RSV | IC, DIGITAL, LOGIC, 4bit DUAL-SUPPLY BUS TRANSCEIVER 3 STATE OUTPUT, 1.2V TO 3.6V, UQFN16, SMD | TEXAS INSTRUMENTS | SN74AVC4T245RSVR | Compliant | Compliant
18-26311 | 1 | U15 | USB3300-EZK | IC, DIGITAL, INTERFACE, HI-SPEED USB HOST, 3.3V, QFN32-EP, SMD | MICROCHIP | USB3300-EZK | Compliant | Compliant
18-30805 | 2 | U33 U38 | TS3A24159DRC | IC, ANALOG, 0.3R DUAL SPDT ANALOG SWITCH DUAL-CHANNEL 2:1 MULTIPLEXER/DEMULTIPLEXER, 1.65V TO 3.6V, SON10-EP, SMD | TEXAS INSTRUMENTS | TS3A24159DRCR | Compliant | Compliant
18-27150 | 1 | U34 | SN74LVC2G74DCU | IC, DIGITAL, LOGIC, D-TYPE FLIP-FLOP WITH CLEAR AND PRESET, 1.65V TO 5.5V, VSSOP8, SMD | TEXAS INSTRUMENTS | SN74LVC2G74DCUR | Compliant
18-33431 | 1 | U35 | ADS127L01IPBS | IC, MIXED, 24-BIT WIDE-BANDWIDTH ANALOG TO DIGITAL CONVERTER, 2.7V TO 3.6V/1.7V TO 3.6V, TQFP32, SMD | TEXAS INSTRUMENTS | ADS127L01IPBS | Compliant | Compliant
18-34413 | 1 | U36 | INA118UB | IC, ANALOG, INSTRUMENTATION AMPLIFIER, -/+15V, SO8, SMD | TEXAS INSTRUMENTS | INA118UB | Compliant | Compliant
18-34391 | 1 | U37 | THS4551IRUN | IC, ANALOG, LOW NOISE, PRECISION, 150MHz, FULLY DIFFERENTIAL AMPLIFIER, 2.7V TO 5.4V, QFN10-EP, SMD | TEXAS INSTRUMENTS | THS4551IRUNR | Compliant | Compliant
18-30809 | 1 | U39 | TS3A4751RUCR | IC, ANALOG, 0.9R LOW-VOLTAGE SINGLE-SUPPLY QUAD SPST ANALOG SWITCH, 1.6V TO 3.6V, QFN14, SMD | TEXAS INSTRUMENTS | TS3A4751RUCR | Compliant | Compliant
18-34390 | 1 | U40 | REF6025IDGK | IC, ANALOG, HIGH PRECISION VOLTAGE REFERENCE, VIN:3V TO 5.5V, VOUT:2.5V, VSSOP8, SMD | TEXAS INSTRUMENTS | REF6025IDGKR | Compliant | Compliant
18-32984 | 1 | U41 | OPA320AIDBV | IC, ANALOG, RAIL-TO-RAIL I/O CMOS OPERATIONAL AMPLIFIER, -/+0.9V TO 5.5V, SOT23-5, SMD | TEXAS INSTRUMENTS | OPA320AIDBVT | Compliant
18-32950 | 1 | U43 | LP5907MFX-1.8 | IC, ANALOG, 0.25A LINEAR REGULATOR FOR RF AND ANALOG CIRCUITS-REQUIRES NO BYPASS CAPACITOR, VIN:2.2V TO 5.5V, VOUT: 1.8V, SOT23-5, SMD | TEXAS INSTRUMENTS | LP5907MFX-1.8/NOPB | Compliant
18-33642 | 1 | U44 | TPS73101DBV | IC, ANALOG, 0.15A LOW DROPOUT REGULATOR WITH REVERSE CURRENT PROTECTION, VIN:1.7V TO 5.5V, VOUT:1.2V TO 5.5V, SOT23-5, SMD | TEXAS INSTRUMENTS | TPS73101DBVR | Compliant
DNM | 0 | U45 | DNM | DNM | DNM | DNM | DNM
18-34886 | 1 | U47 | TPS259530DSG | IC, ANALOG, EFUSE WITH FAST OVERVOLTAGE PROTECTION, 2.7V TO 18V, WSON8-EP, SMD | TEXAS INSTRUMENTS | TPS259530DSGR | Compliant
18-29511 | 1 | U5 | TM4C1294NCPDTT3R | IC, MICROCONTROLLER, TIVA C SERIES, ARM CRTEX-M4, 2.97V TO 3.63V, TQFP128, SMD | TEXAS INSTRUMENTS | TM4C1294NCPDTT3R | Compliant | Compliant
12-00546 | 1 | Y1 | 32.768kHz | CRYSTAL, RESONATOR, 32.768kHz, -20PPM/+20PPM, -40DEGC/+85DEGC, SMD | EPSON | FC-135 32.7680KA-AG0 | Exempt | Non-Compliant
12-01233 | 1 | Y2 | 48MHz | CRYSTAL, RESONATOR, 48MHz, -20PPM/+20PPM, -40DEGC/+85DEGC, SMD | KYOCERA | CX2016DB48000C0FPLC1 | Compliant | Compliant
12-00745 | 1 | Y3 | 16MHz | CRYSTAL, RESONATOR, 16MHz, -30PPM/+30PPM, -40DEGC/+85DEGC, SMD | NIHON DEMPA KOGYO | NX3225GA-16.000M-STD-CRG-1 | Exempt | Compliant
12-00730 | 1 | Y4 | 24MHz | CRYSTAL, RESONATOR, 24MHz, -50PPM/+50PPM, -40DEGC/+85DEGC, SMD | EPSON | FA-238 24.0000MB50X-W0 | Compliant | Compliant
12-01320 | 1 | Y5 | 16.384MHz | CRYSTAL, OSCILLATOR, XO, 16.384MHz, -50PPM/+50PPM, 3.3V, -20DEGC/+70DEGC, SMD | CTS COMPONENTS | 636L3C016M38400 | Compliant | Compliant
