perigoso/haptic-control/documentation/WCS037B/Assembly Drawing/WCS037B_mech.pdf

## ART FILM - drill

A

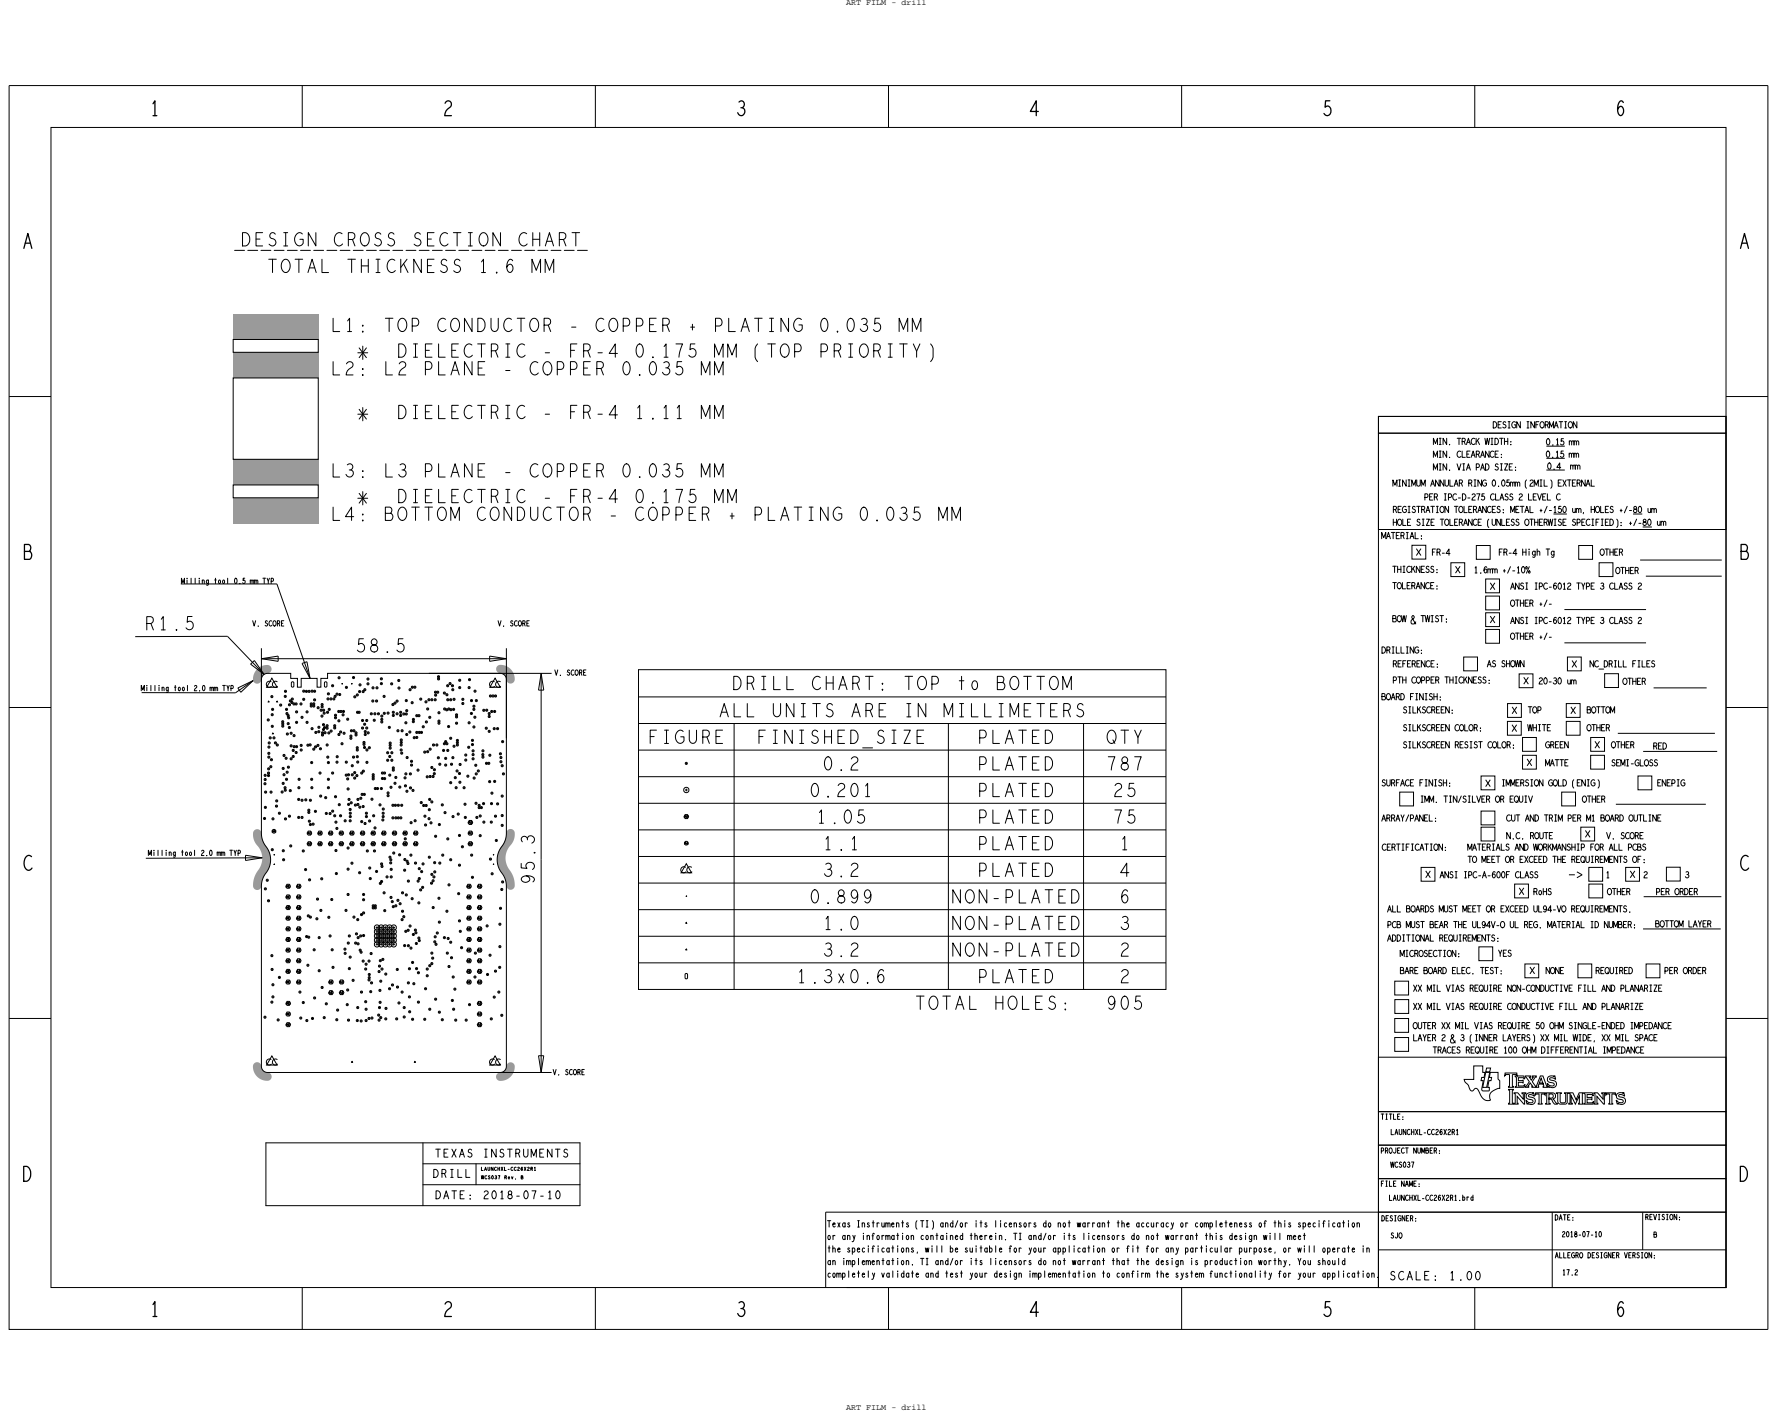
[picture p4: page 1]
RED; ENEPIG; PER ORDER; BOTTOM LAYER; REVISION:; OTHER; NC_DRILL FILES; BOTTOM; SEMI-GLOSS; V. SCORE; REQUIRED; GREEN; WHITE; TOP; MATTE; RoHS; YES; NONE; DATE:; ALLEGRO DESIGNER VERSION:; DESIGN INFORMATION; AS SHOWN; THICKNESS:; TOLERANCE:; BOW & TWIST:; SURFACE FINISH:; ARRAY/PANEL:; CERTIFICATION:; TITLE:; LAUNCHXL-CC26X2R1; PROJECT NUMBER:; FILE NAME:; WCS037; LAUNCHXL-CC26X2R1.brd; DESIGNER:; SJO; SCALE: 1.00; QTY 787 25 75 1 4 6 3 2 2 905; PLATED PLATED PLATED PLATED PLATED PLATED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

___________________________ DESIGN CROSS SECTION CHART
TOTAL THICKNESS 1.6 MM

L1: TOP CONDUCTOR - COPPER + PLATING 0.035 MM
* DIELECTRIC - FR-4 0.175 MM (TOP PRIORITY)
L2: L2 PLANE - COPPER 0.035 MM

* DIELECTRIC - FR-4 1.11 MM

MIN. TRACK WIDTH:
MIN. CLEARANCE:
MIN. VIA PAD SIZE:

L3: L3 PLANE - COPPER 0.035 MM
* DIELECTRIC - FR-4 0.175 MM
L4: BOTTOM CONDUCTOR - COPPER + PLATING 0.035 MM

MINIMUM ANNULAR RING 0.05mm (2MIL) EXTERNAL
PER IPC-D-275 CLASS 2 LEVEL C
REGISTRATION TOLERANCES: METAL +/-150 um, HOLES +/-80 um
HOLE SIZE TOLERANCE (UNLESS OTHERWISE SPECIFIED): +/-80 um
MATERIAL:

FR-4 High Tg

Milling tool 0.5 mm TYP

ANSI IPC-6012 TYPE 3 CLASS 2
OTHER +/-

DRILLING:
REFERENCE:
PTH COPPER THICKNESS:
BOARD FINISH:
SILKSCREEN:
SILKSCREEN COLOR:
SILKSCREEN RESIST COLOR:

Milling tool 2.0 mm TYP

IMMERSION GOLD (ENIG)

IMM. TIN/SILVER OR EQUIV

CUT AND TRIM PER M1 BOARD OUTLINE
N.C. ROUTE

MATERIALS AND WORKMANSHIP FOR ALL PCBS
TO MEET OR EXCEED THE REQUIREMENTS OF:
ANSI IPC-A-600F CLASS

ALL BOARDS MUST MEET OR EXCEED UL94-VO REQUIREMENTS.
PCB MUST BEAR THE UL94V-O UL REG. MATERIAL ID NUMBER:
ADDITIONAL REQUIREMENTS:
MICROSECTION:
BARE BOARD ELEC. TEST:
XX MIL VIAS REQUIRE NON-CONDUCTIVE FILL AND PLANARIZE
XX MIL VIAS REQUIRE CONDUCTIVE FILL AND PLANARIZE
OUTER XX MIL VIAS REQUIRE 50 OHM SINGLE-ENDED IMPEDANCE
LAYER 2 & 3 (INNER LAYERS) XX MIL WIDE, XX MIL SPACE
TRACES REQUIRE 100 OHM DIFFERENTIAL IMPEDANCE

TEXAS INSTRUMENTS

DRILL | LAUNCHXL-CC26X2R1 WCS037 Rev. B

Texas Instruments (TI) and/or its licensors do not warrant the accuracy or completeness of this specification
or any information contained therein. TI and/or its licensors do not warrant this design will meet
the specifications, will be suitable for your application or fit for any particular purpose, or will operate in
an implementation. TI and/or its licensors do not warrant that the design is production worthy. You should
completely validate and test your design implementation to confirm the system functionality for your application.

ART FILM - drill
