perigoso/haptic-control/documentation/WCS037B/Assembly Drawing/WCS037B_assy.pdf

# ART FILM - assembly_top

C46R353

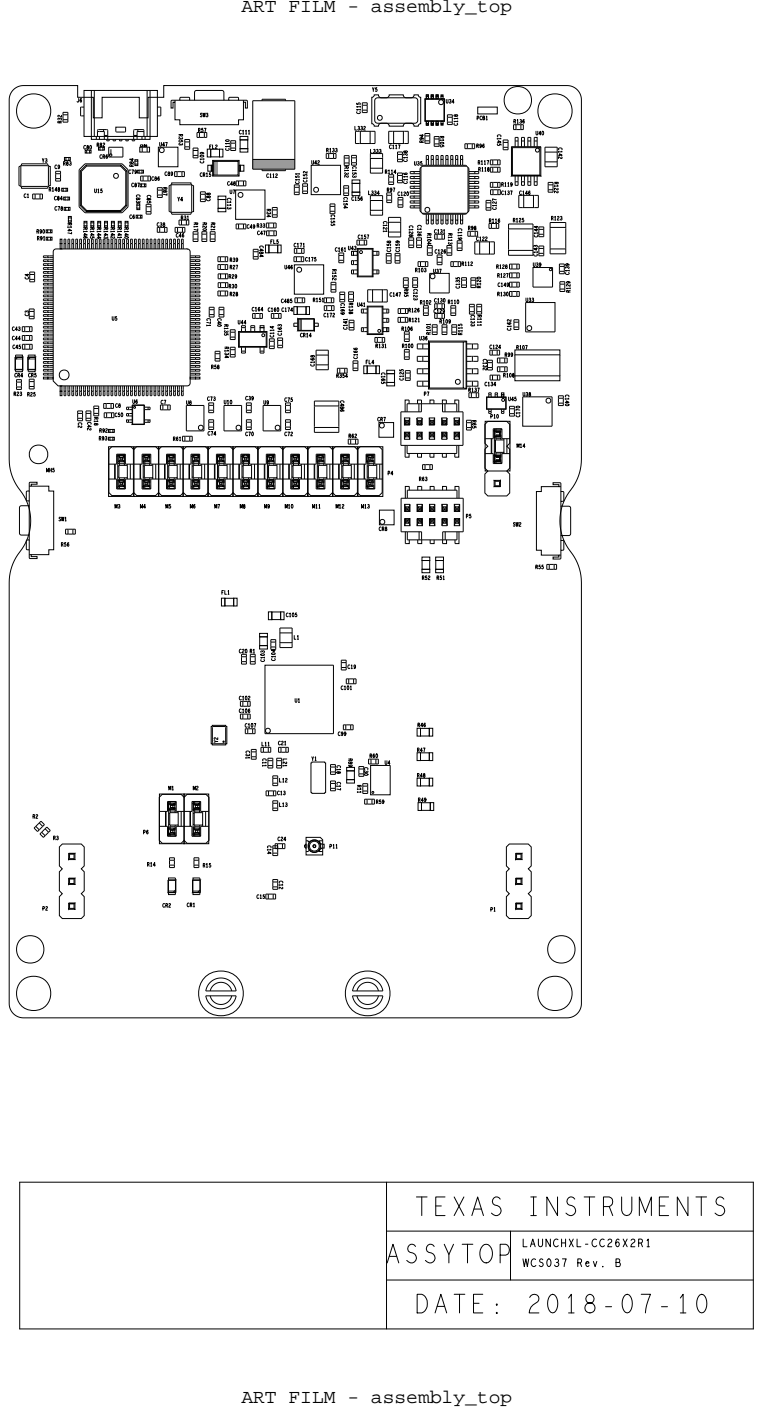
[picture p5: page 1]

TEXAS INSTRUMENTS

ASSYTOP | LAUNCHXL-CC26X2R1 WCS037 Rev. B

# ART FILM - assembly_bottom_mirrored

M16

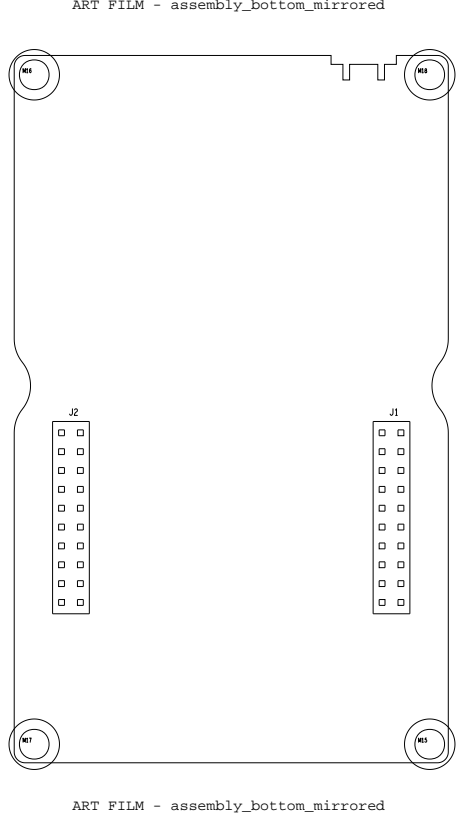
[picture p6: page 2]
ART FILM - assembly_bottom_mirrored
