perigoso/haptic-control/pcb/haptic-control-sch.pdf

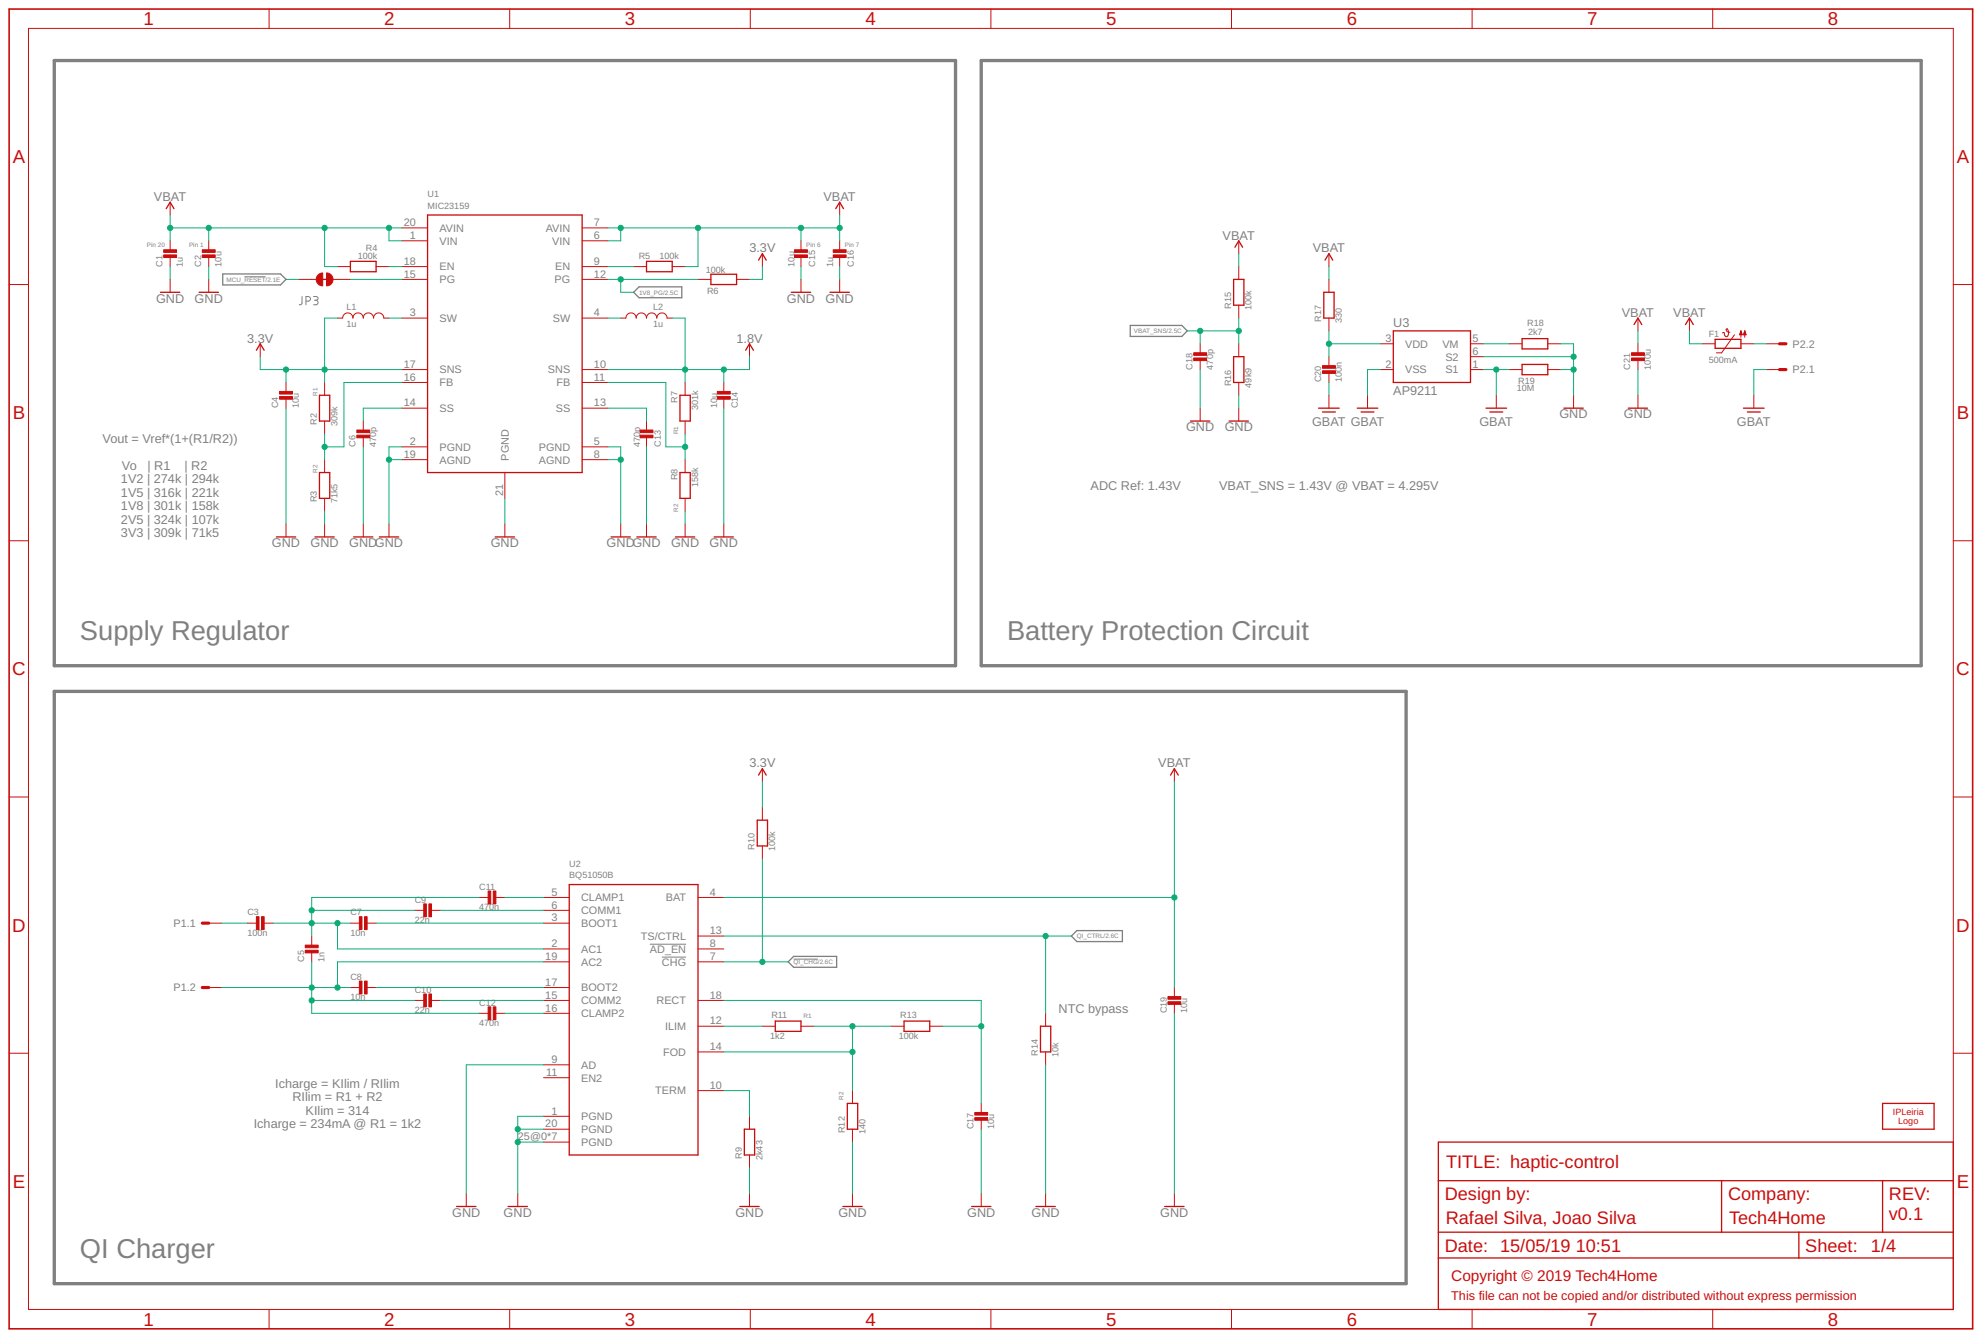
[picture p7: page 1]

2k43 GND GND GND GND GND

Design by: Rafael Silva, Joao Silva | Company: Tech4Home | REV: v0.1

Date: 15/05/19 10:51 | Sheet: 1/4

Copyright © 2019 Tech4Home
This file can not be copied and/or distributed without express permission

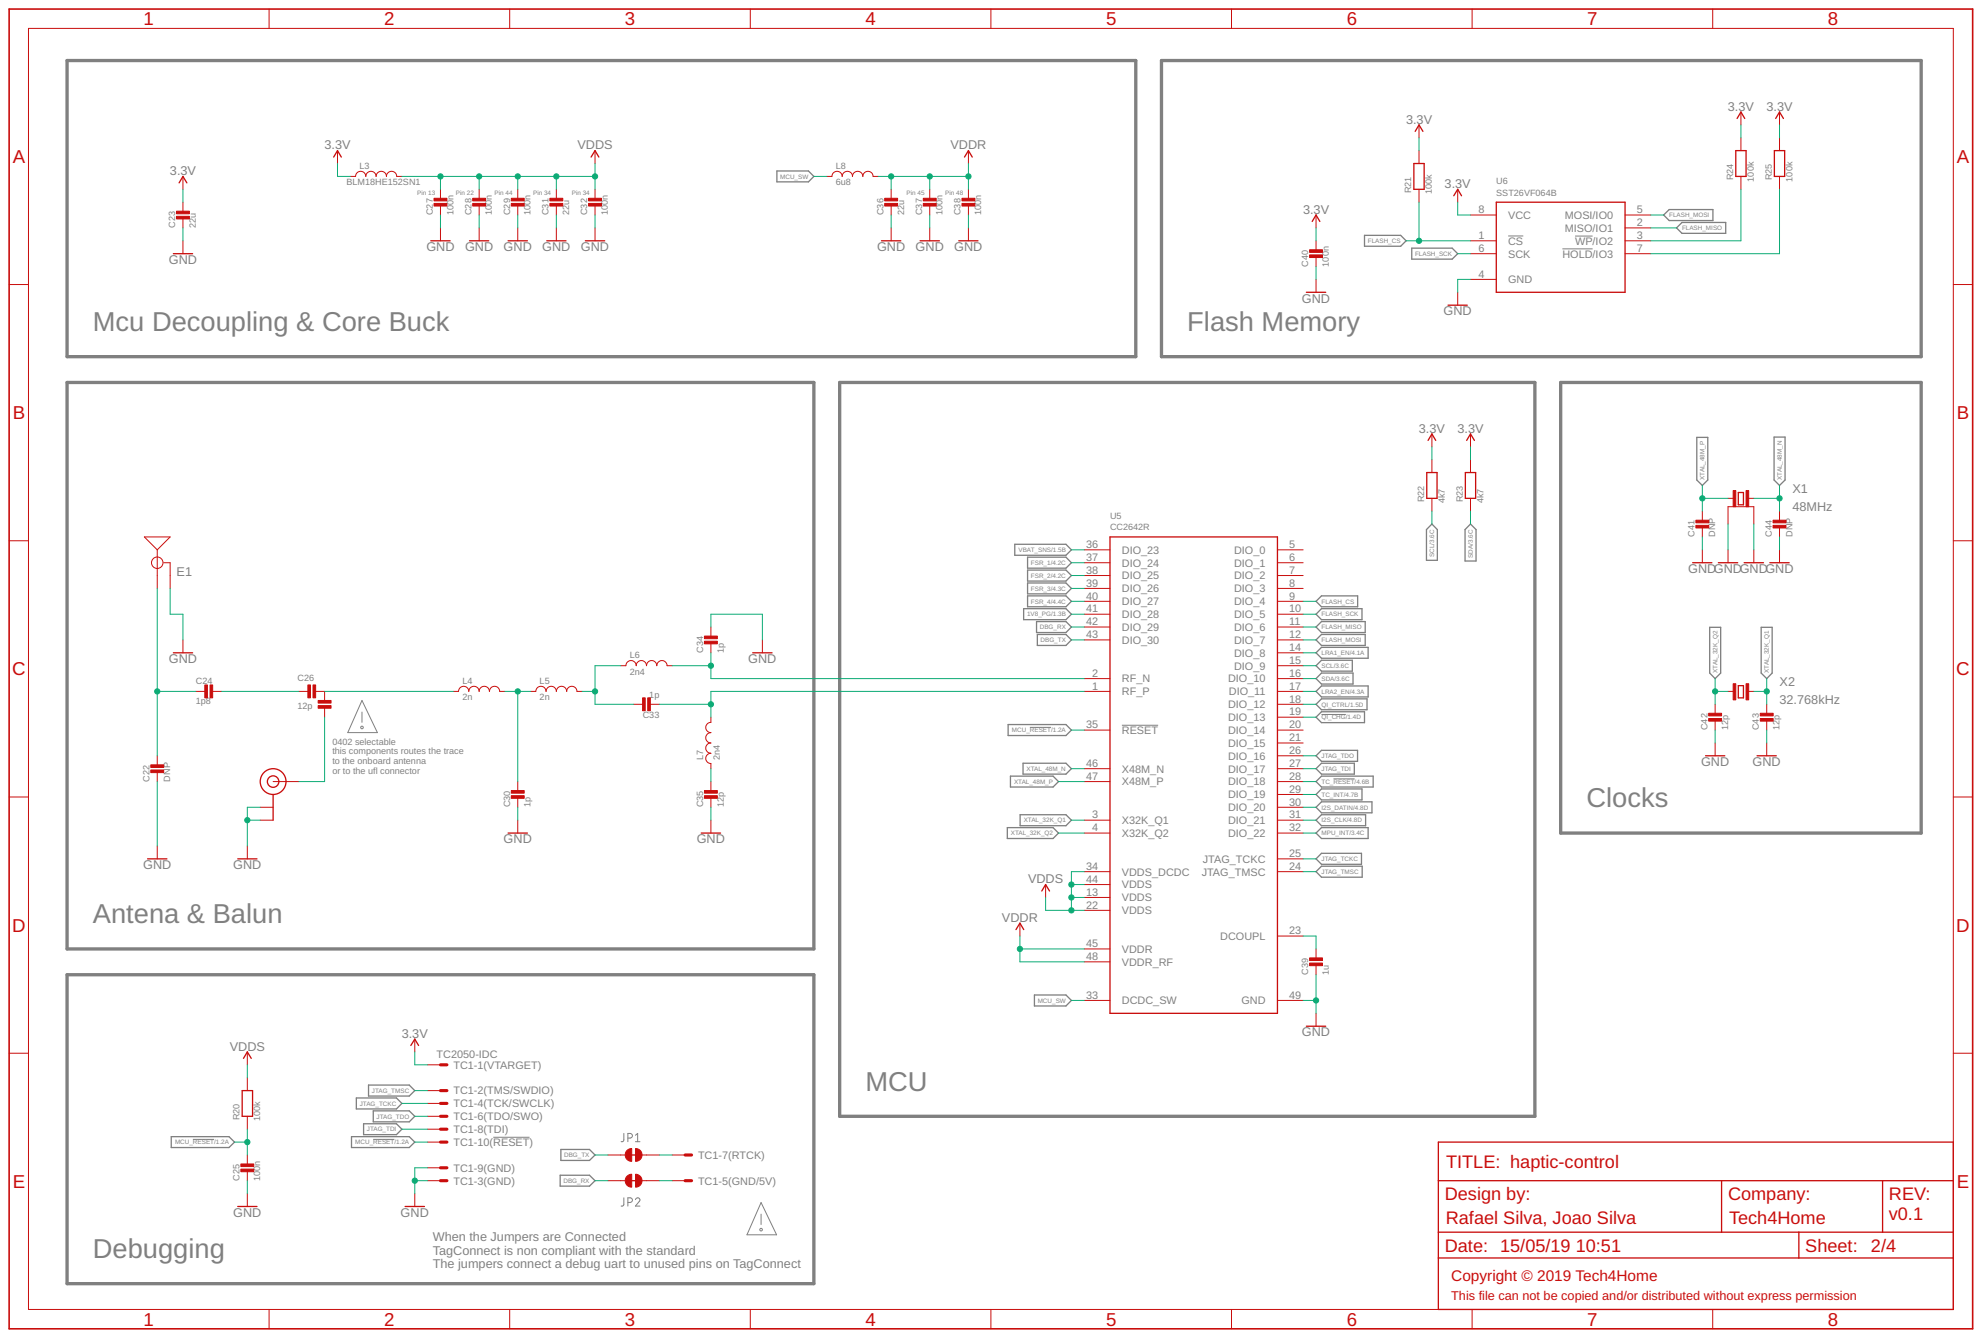
[picture p8: page 2]

0402 selectable
this components routes the trace
to the onboard antenna
or to the ufl connector

GND
When the Jumpers are Connected
TagConnect is non compliant with the standard
The jumpers connect a debug uart to unused pins on TagConnect

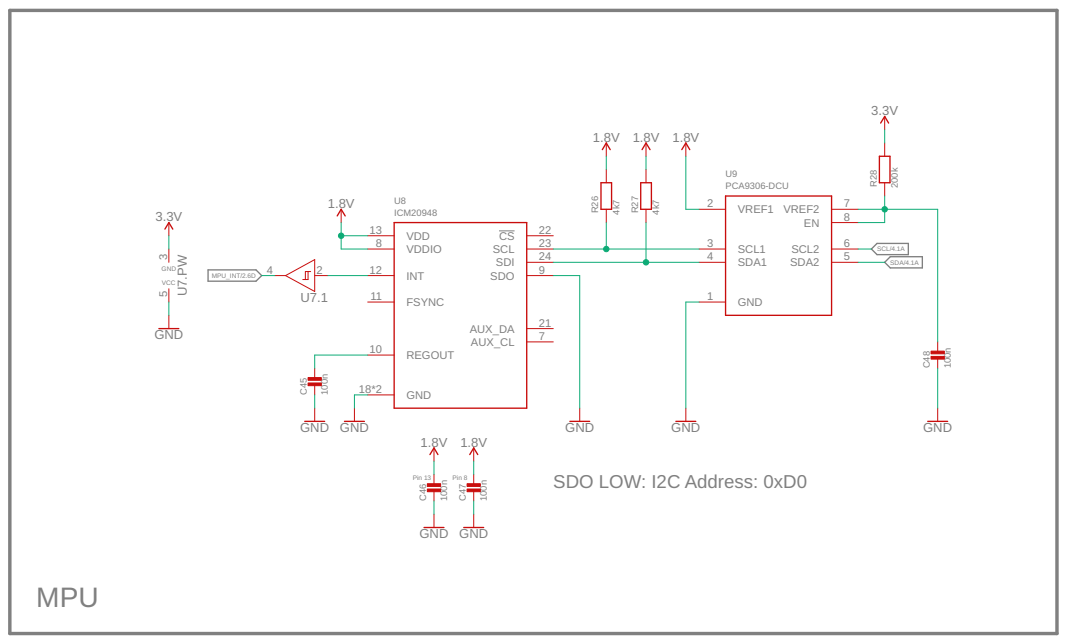
[picture p9: page 3]

Design by: Rafael Silva, Joao Silva | Company: Tech4Home | REV: v0.1

Date: 15/05/19 10:51 | Sheet: 3/4

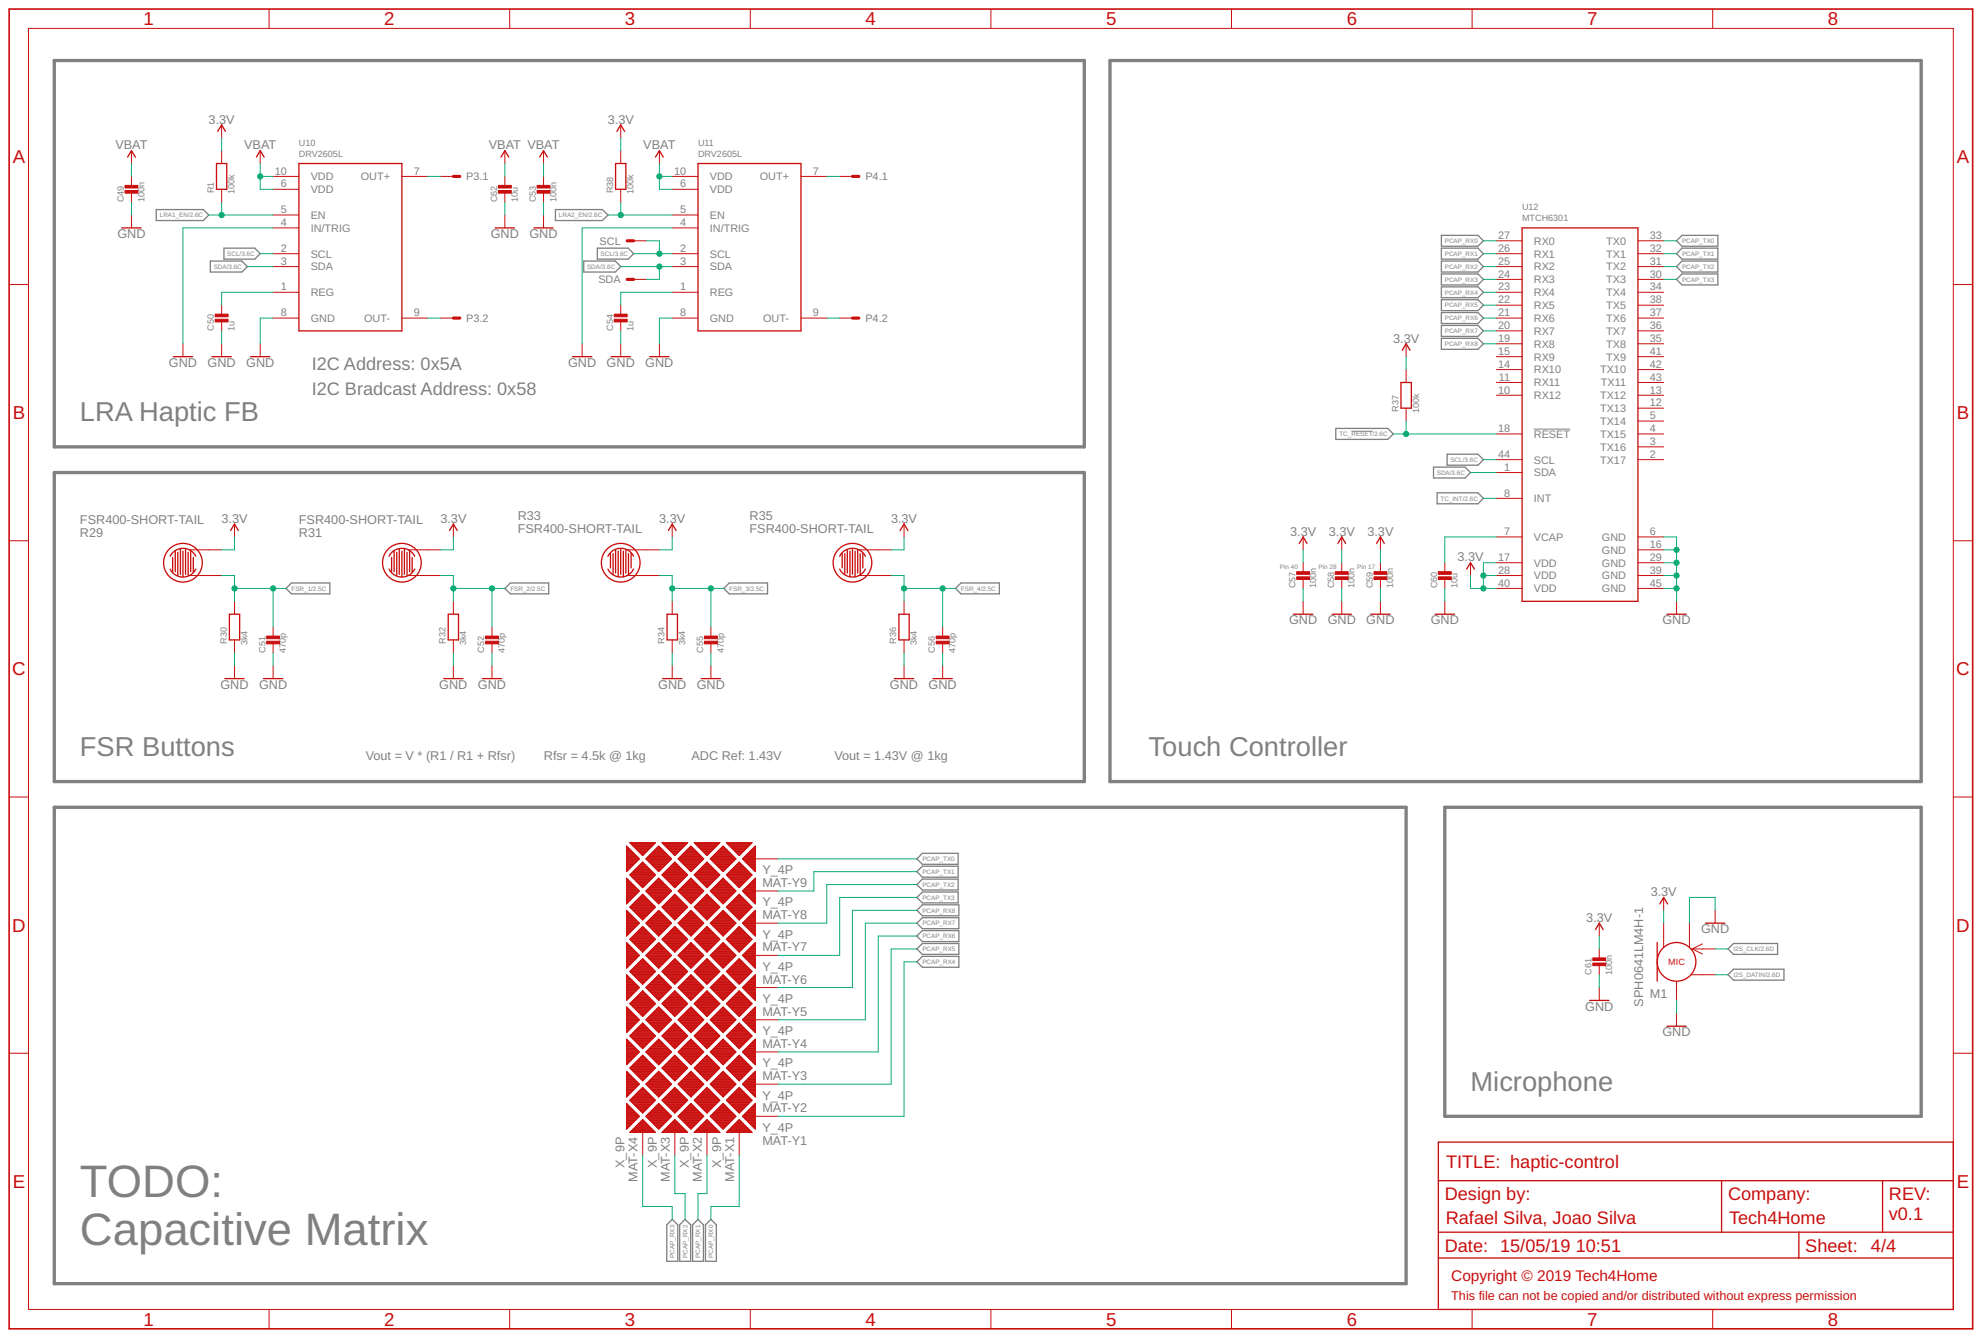
[picture p10: page 4]

Design by: Rafael Silva, Joao Silva | Company: Tech4Home | REV: v0.1

Date: 15/05/19 10:51 | Sheet: 4/4
