perigoso/haptic-control/pcb/haptic-control-bot.pdf

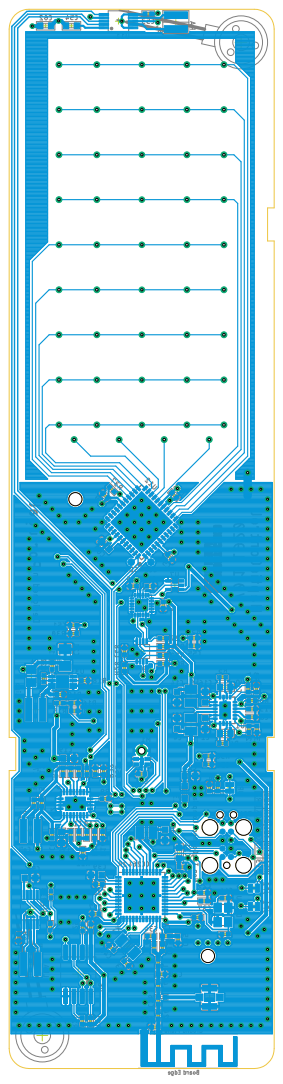
[picture p11: page 1]
