perigoso/haptic-control/pcb/haptic-control-top.pdf

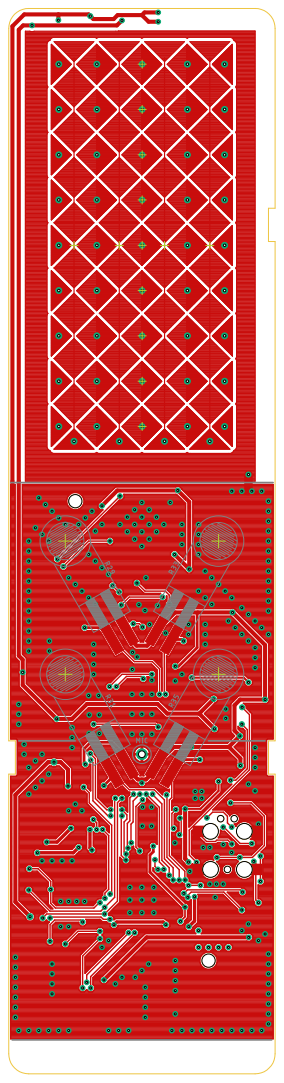
[picture p12: page 1]
