perigoso/haptic-control/documentation/WCS037B/PCB Layer Plots/WCS037B_layout.pdf

# ART FILM - Top

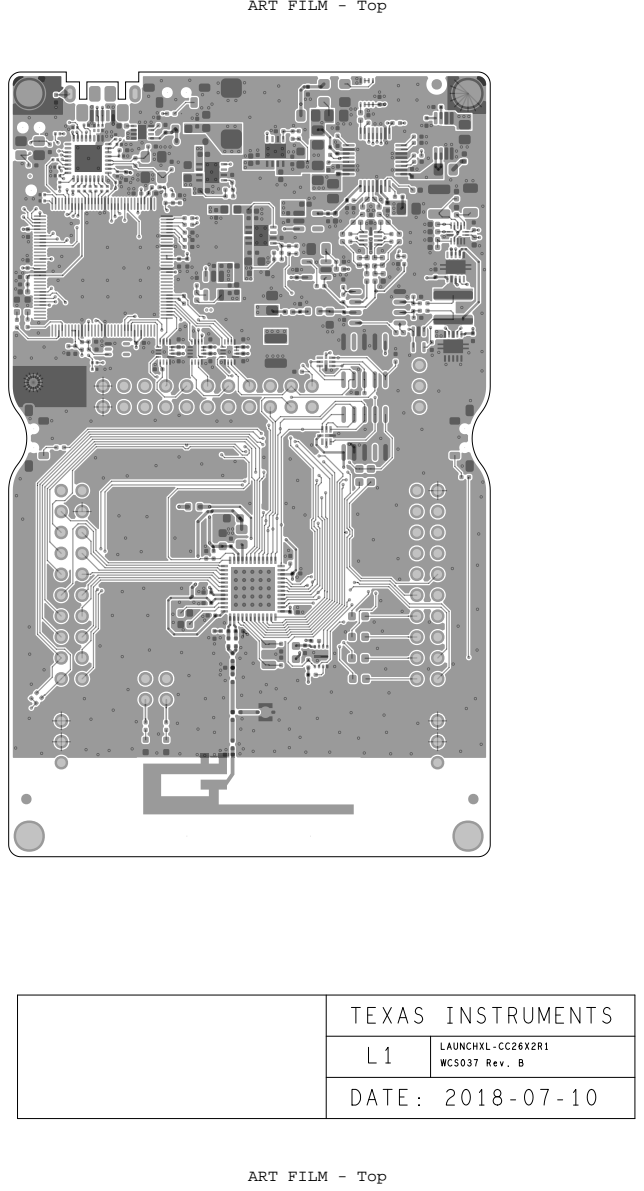
[picture p13: page 1]
DATE: 2018-07-10

TEXAS INSTRUMENTS

L1 | LAUNCHXL-CC26X2R1 WCS037 Rev. B

ART FILM - Top

# ART FILM - Layer2

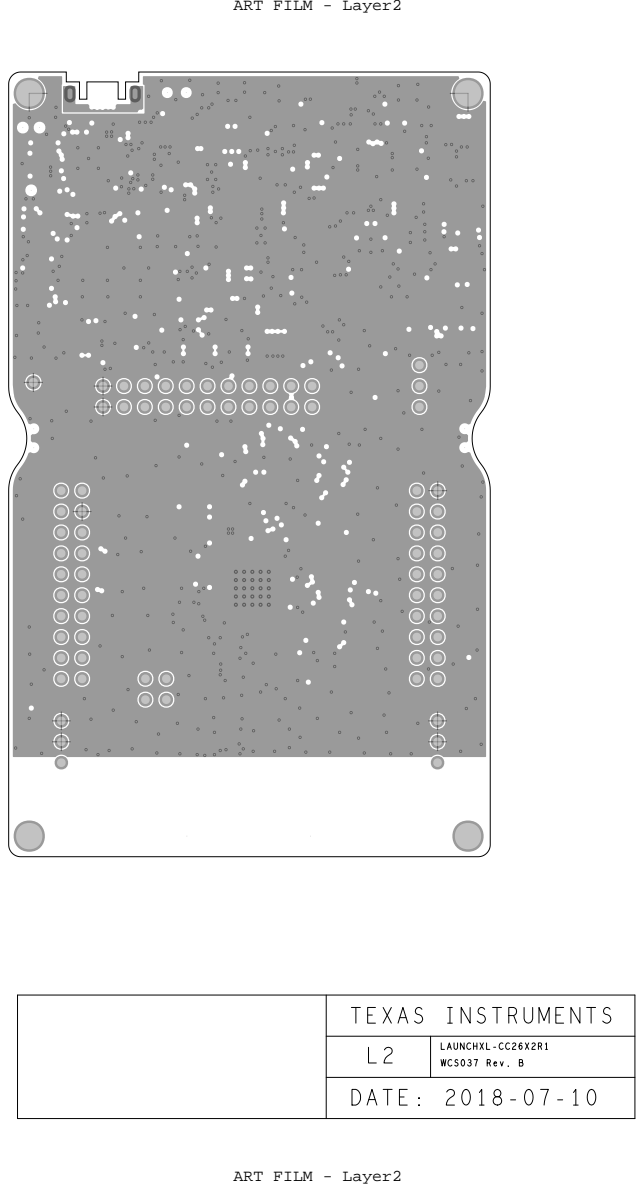
[picture p14: page 2]
ART FILM - Layer2

TEXAS INSTRUMENTS

L2 | LAUNCHXL-CC26X2R1 WCS037 Rev. B

# ART FILM - Layer3

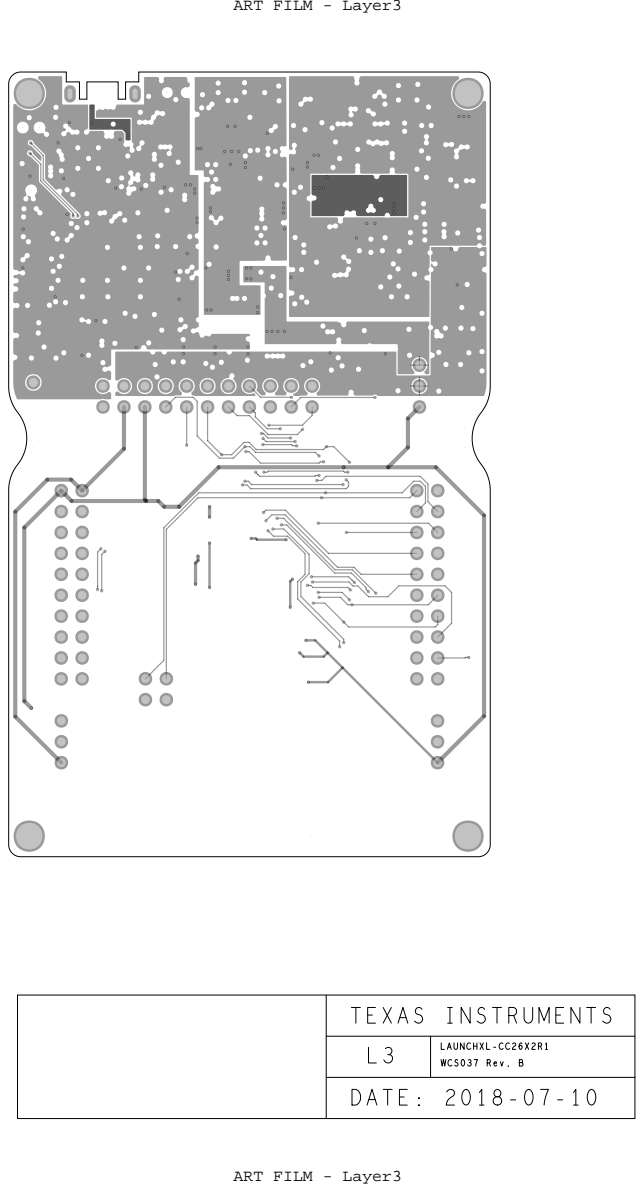
[picture p15: page 3]
ART FILM - Layer3

TEXAS INSTRUMENTS

L3 | LAUNCHXL-CC26X2R1 WCS037 Rev. B

# ART FILM - Bottom

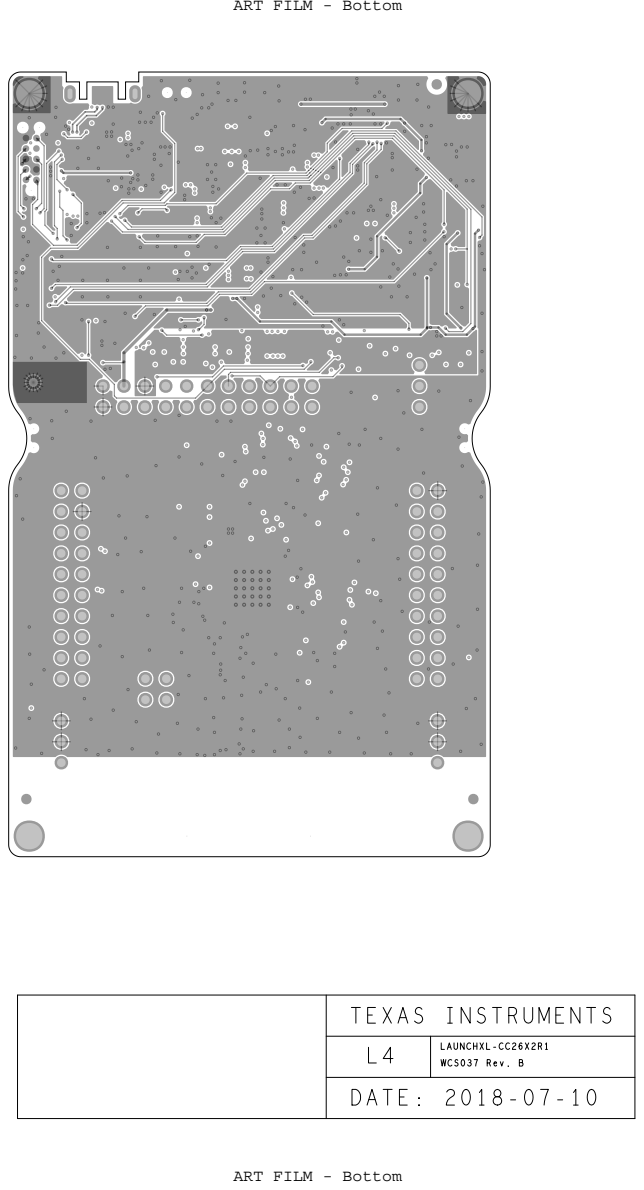
[picture p16: page 4]

TEXAS INSTRUMENTS

L4 | LAUNCHXL-CC26X2R1 WCS037 Rev. B

ART FILM - Bottom

# ART FILM - soldmask_top

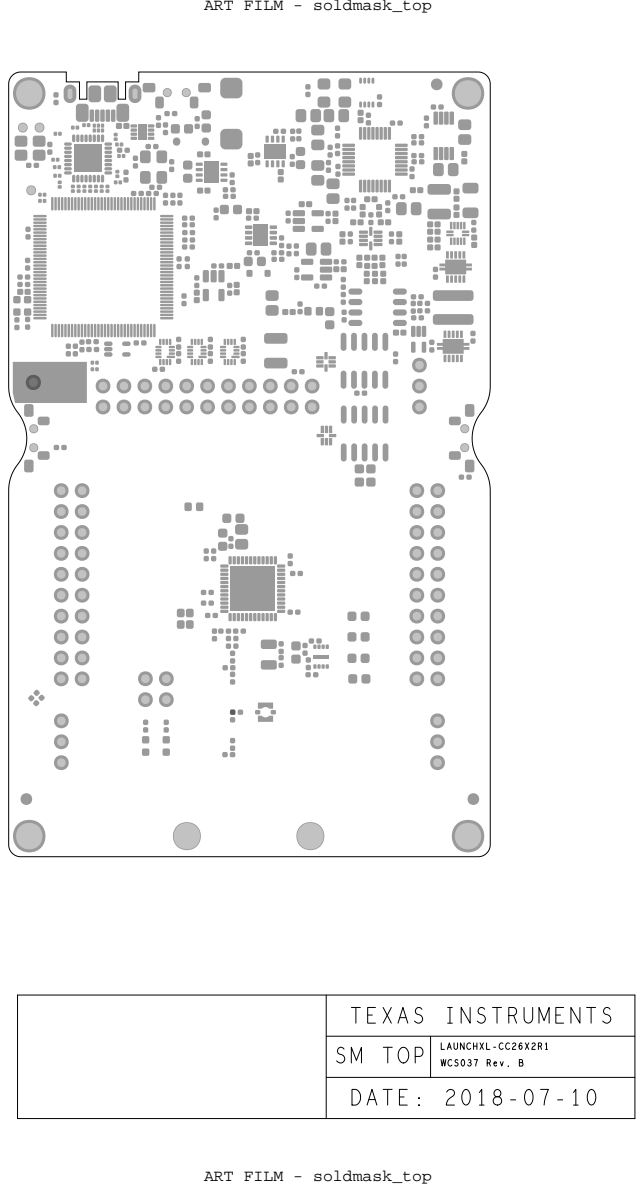
[picture p17: page 5]
ART FILM - soldmask_top

TEXAS INSTRUMENTS

SM TOP | | LAUNCHXL-CC26X2R1 WCS037 Rev. B

# ART FILM - soldmask_bottom

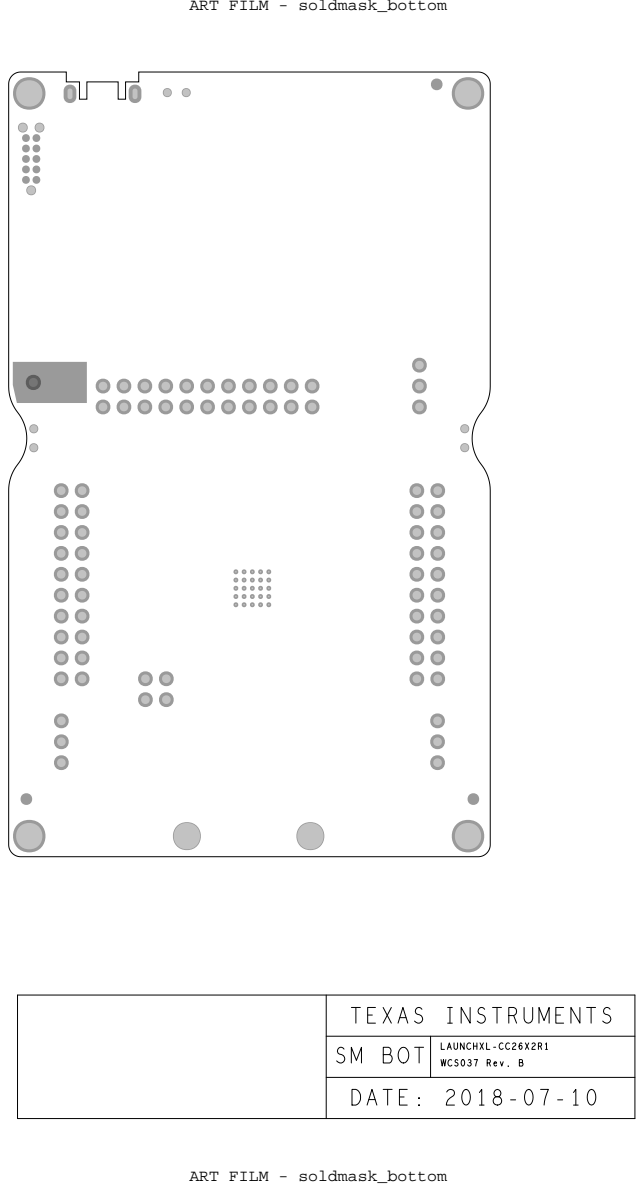
[picture p18: page 6]
ART FILM - soldmask_bottom

TEXAS INSTRUMENTS

SM BOT | | LAUNCHXL-CC26X2R1 WCS037 Rev. B

# ART FILM - silk_top

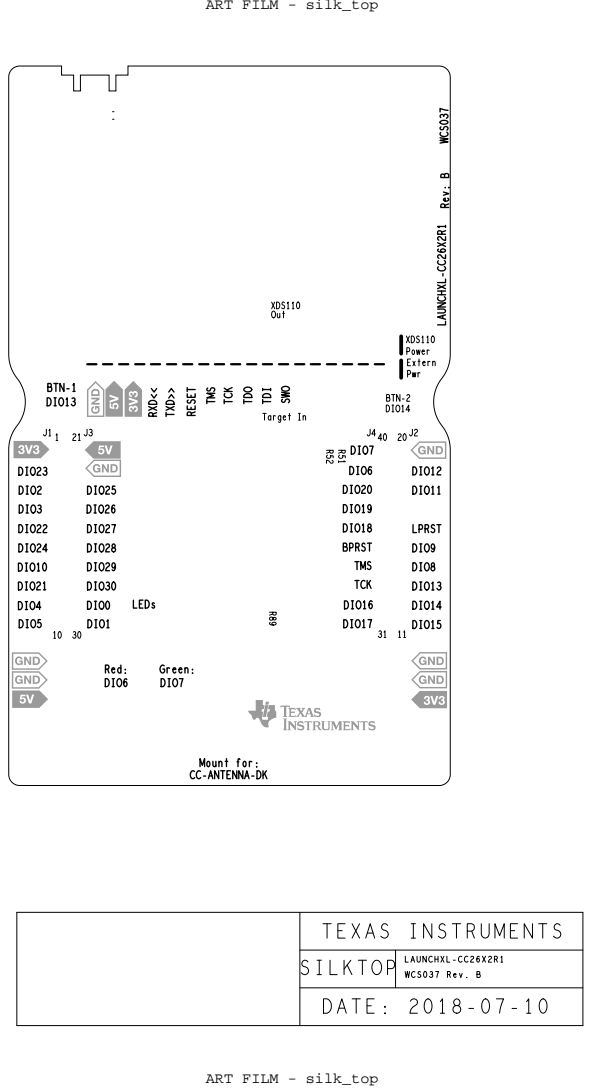
[picture p19: page 7]
ART FILM - silk_top; WCS037 Rev: B LAUNCHXL-CC26X2R1; Pwr; Extern; Power; XDS110; DIO14; BTN-2; DIO7; DIO6; DIO12; DIO11; LPRST DIO9; TCK DIO16; TMS; DIO8; DIO13 DIO14 DIO15; Out; Target In; TDO; TDI; SWO; R51 DIO20; DIO19 DIO18 BPRST; DIO17; TCK; RESET; RXD<<; TXD>>; Green:; LEDs; DIO13; BTN-1; DIO26; DIO25; DIO27; DIO24; DIO28; DIO22; DIO2 DIO3; DIO23; Red:; DIO29 DIO30 DIO0 DIO1; DIO21; DIO10; DIO5; DIO4

Mount for:
CC-ANTENNA-DK

TEXAS INSTRUMENTS

SILKTOP | | LAUNCHXL-CC26X2R1 WCS037 Rev. B

# ART FILM - silk_bottom

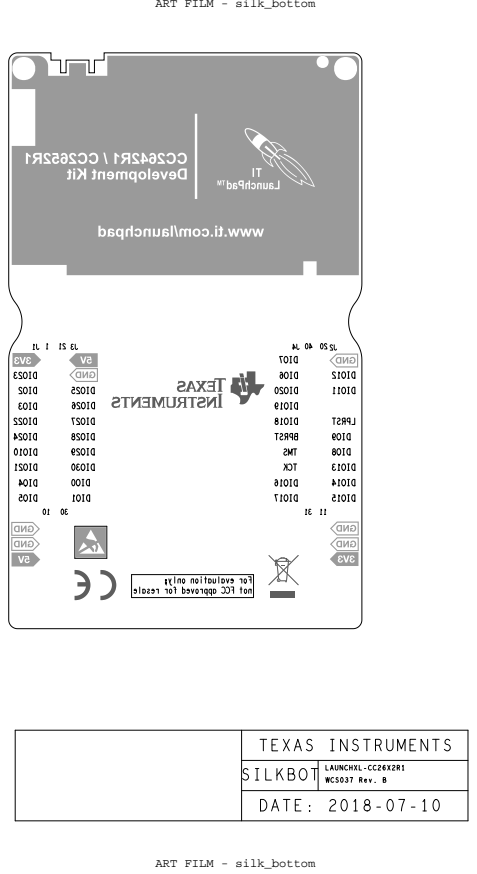
[picture p20: page 8]
ART FILM - silk_bottom; DIO12 DIO11; LPRST DIO9; DIO7 DIO6; DIO8 DIO13 DIO14 DIO15; TCK; TMS; DIO20 DIO19 DIO18 BPRST; DIO17; DIO16; DIO26; DIO25; DIO27 DIO24 DIO28; DIO22; DIO2 DIO3; DIO23; DIO29 DIO30 DIO0 DIO1; DIO21; DIO10; DIO5; DIO4

For evaluation only;

not FCC approved for resale

TEXAS INSTRUMENTS

SILKBOT | | LAUNCHXL-CC26X2R1 WCS037 Rev. B

# ART FILM - paste_top

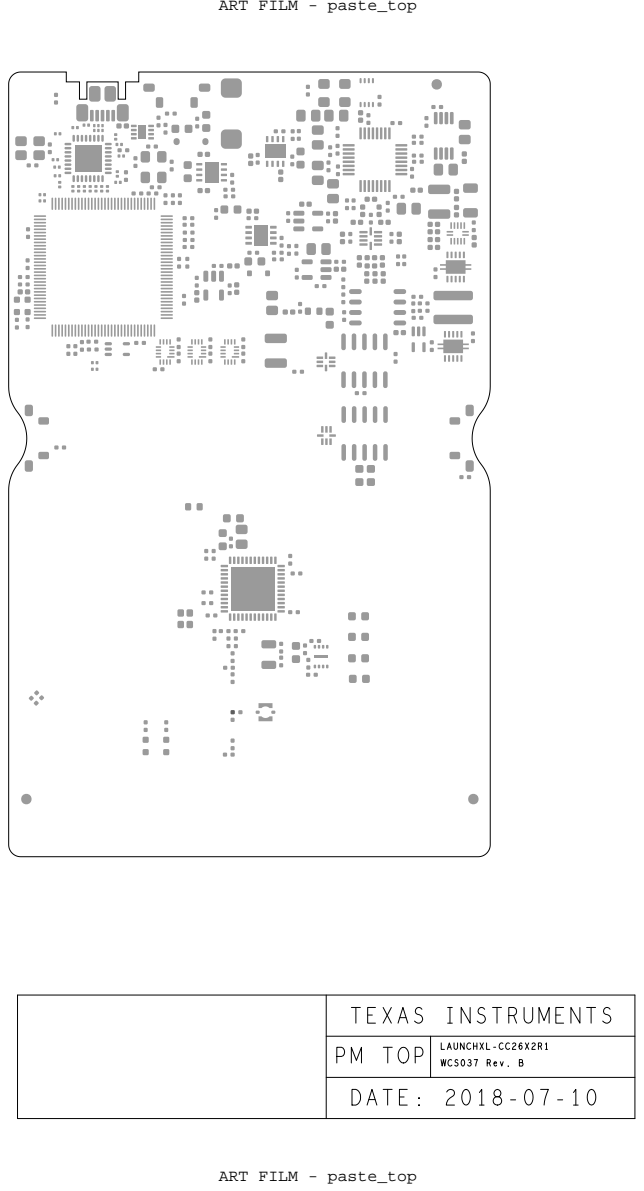
[picture p21: page 9]
ART FILM - paste_top

TEXAS INSTRUMENTS

PM TOP | LAUNCHXL-CC26X2R1 WCS037 Rev. B

# ART FILM - paste_bottom

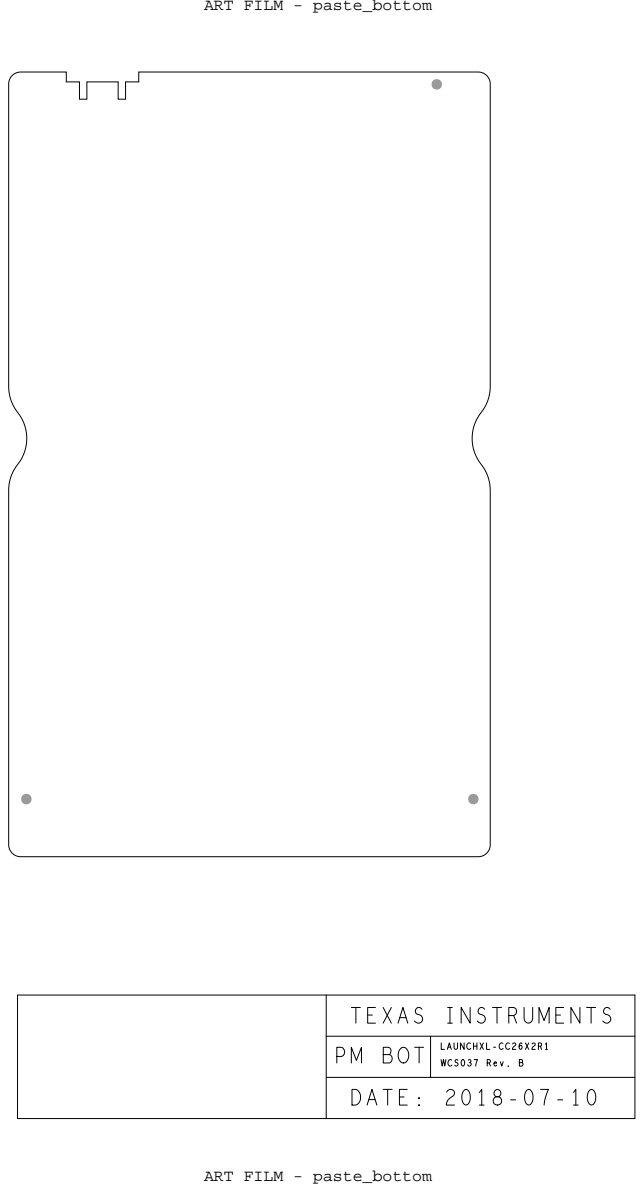
[picture p22: page 10]
ART FILM - paste_bottom

TEXAS INSTRUMENTS

PM BOT | | LAUNCHXL-CC26X2R1 WCS037 Rev. B
