perigoso/haptic-control/(list of files, drawings)

Other design files:
documentation/WCS037B/CAD Source/WCS037B.DSN
