perigoso/haptic-control/pcb/haptic-control.brd

## EAGLE design pcb/haptic-control.brd (2019-05-21)

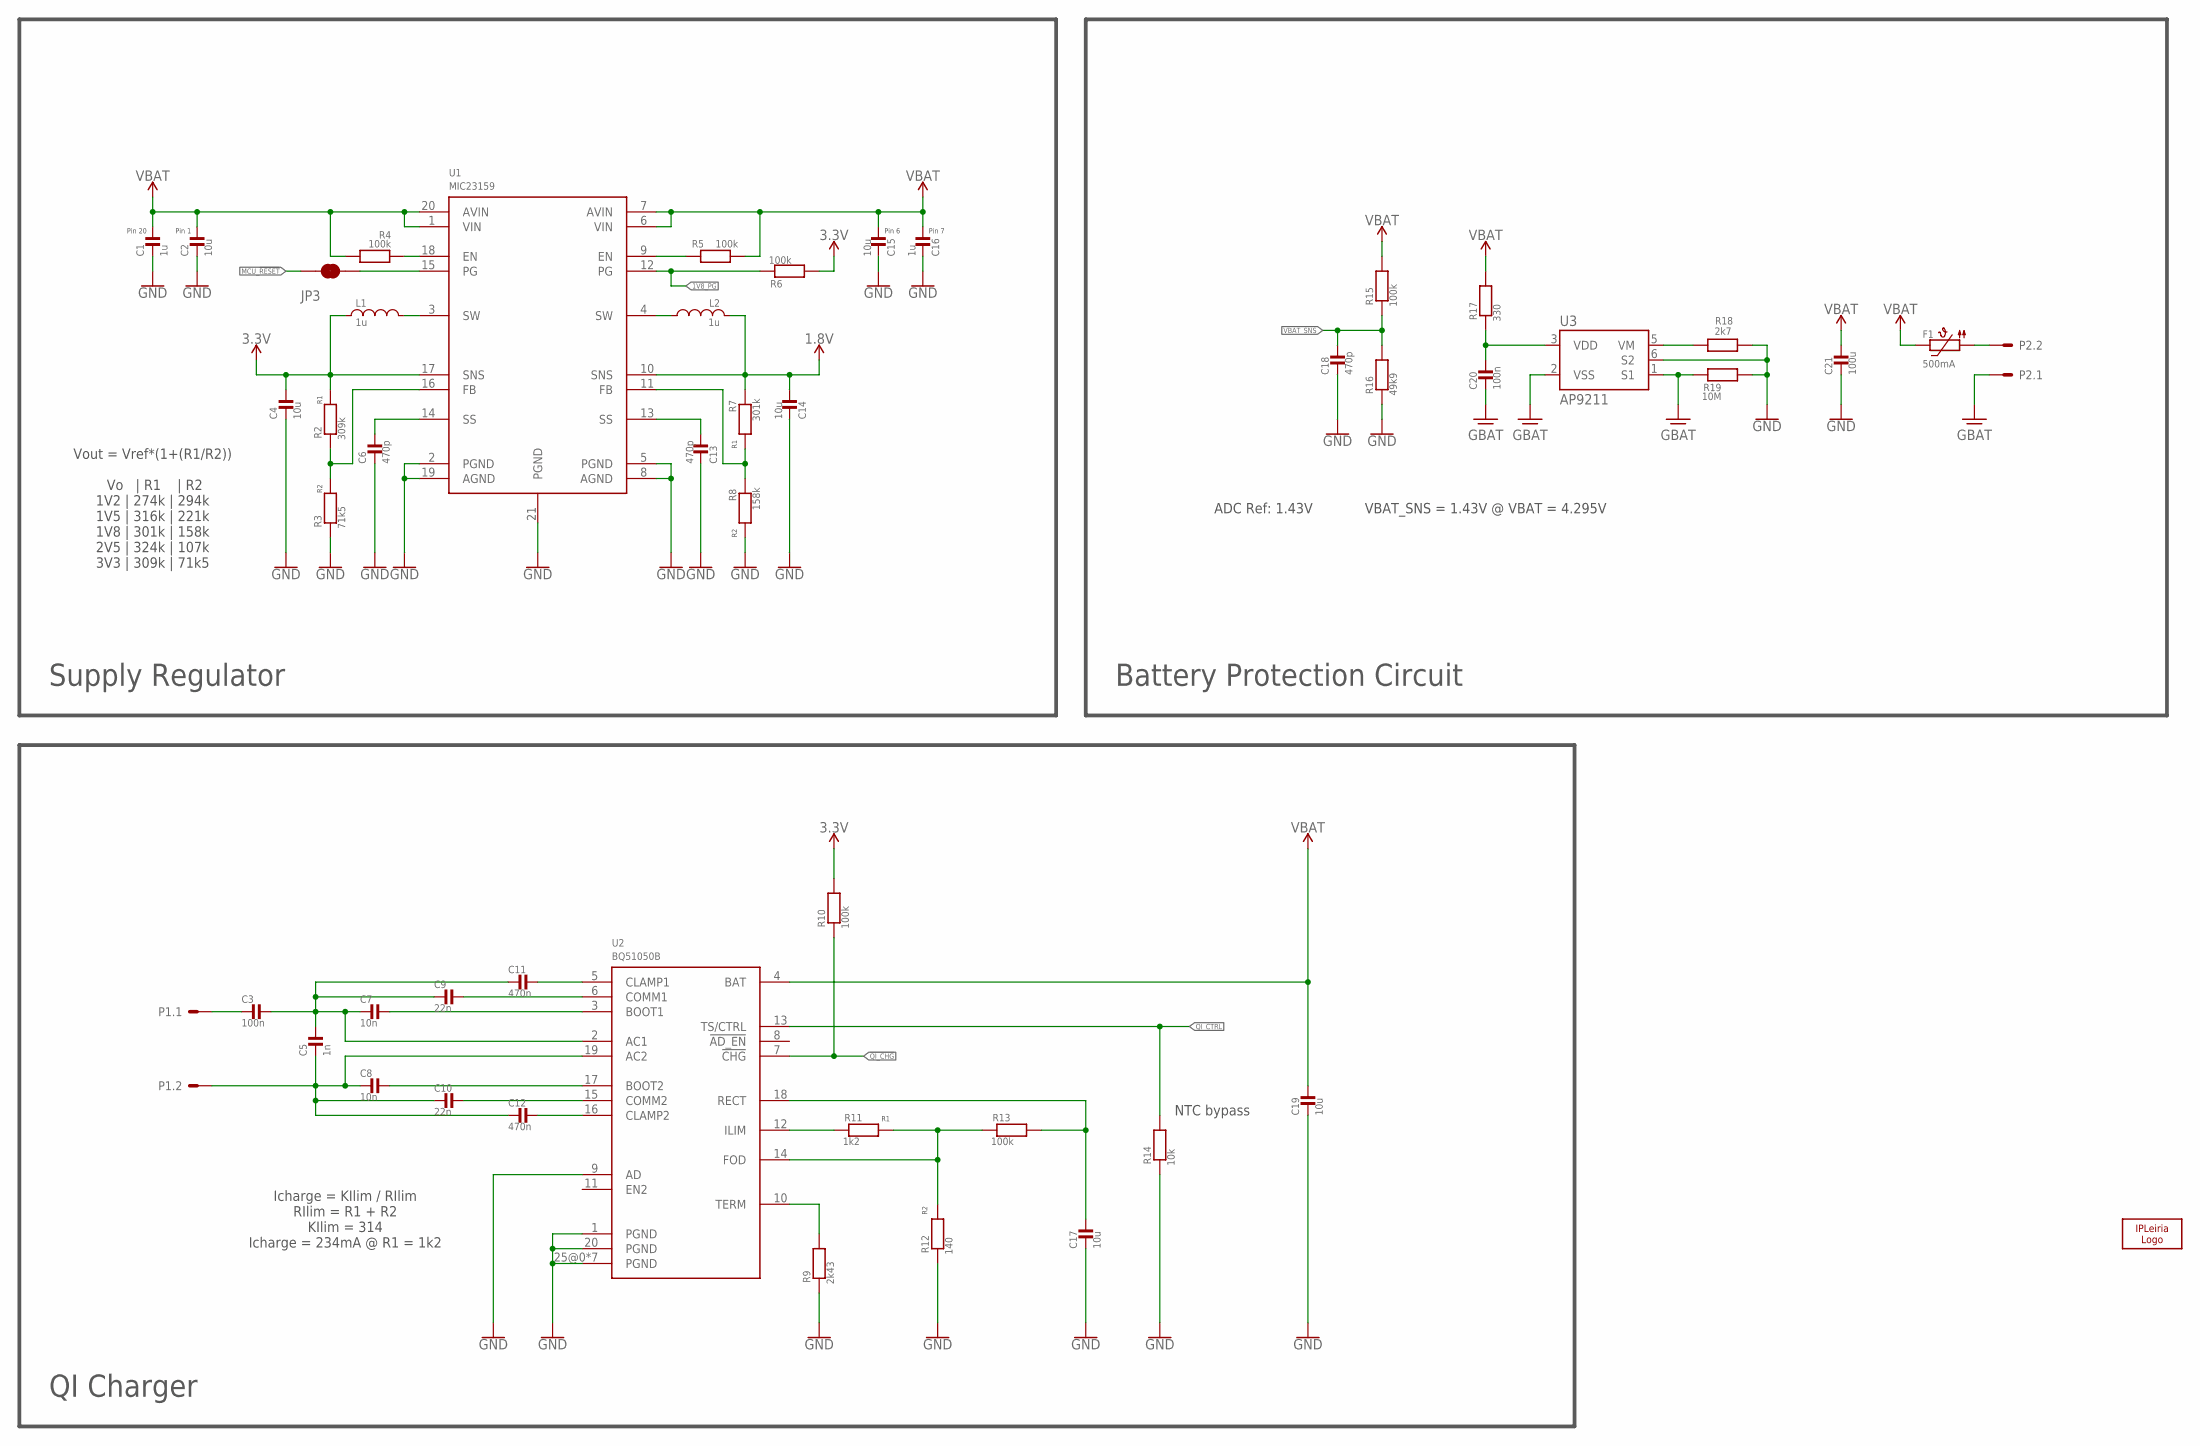
[picture p23: schematic haptic-control.sch, sheet 1, Power]

Parts:
C1, C16: 1u; 0603_WAVE
C2, C4, C14, C15, C17, C19: 10u; 0603_WAVE
C3, C20: 100n; _0402
C5: 1n; _0402
C6, C13, C18: 470p; _0402
C7, C8: 10n; _0402
C9, C10: 22n; _0402
C11, C12: 470n; _0402
C21: 100u; _1206
F1: 500mA; 0805
JP3: JUMPER-SMT_2_NC_TRACE_SILK; SMT-JUMPER_2_NC_TRACE_SILK
L1, L2: 1u; _0806
LOGO1: IPL-10MM; IPL_10MM
P1, P2: 2P-PAD_1X3.5; PAD1X3_5MM-2P
R2: 309k; _0402
R3: 71k5; _0402
R4, R5, R6, R10, R13, R15: 100k; _0402
R7: 301k; _0402
R8: 158k; _0402
R9: 2k43; _0402
R11: 1k2; _0402
R12: 140; _0402
R14: 10k; _0402
R16: 49k9; _0402
R17: 330; _0402
R18: 2k7; _0402
R19: 10M; _0402
U1: MIC23159; VQFN20
U2: BQ51050B; VQFN20
U3: AP9211; DFN2030-6

Connections:
1.8V: C14.P$1, L2.1, R7.1, U1.10 (SNS); also elsewhere on the board
1V8_PG: R6.1, U1.12 (PG); also elsewhere on the board
3.3V: C4.P$1, L1.1, R2.2, R6.2, R10.2, U1.17 (SNS); also elsewhere on the board
!QI_CHG: R10.1, U2.7 (!CHG); also elsewhere on the board
GBAT: C20.2, P2.1, R19.1, U3.1 (S1), U3.2 (VSS)
GND: C1.P$2, C2.P$2, C4.P$2, C6.2, C13.2, C14.P$2, C15.P$2, C16.P$2, C17.P$2, C18.2, C19.P$2, C21.2, R3.1, R8.2, R9.1, R12.1, R14.1, R16.1, R18.1, R19.2, U1.2 (PGND), U1.5 (PGND), U1.8 (AGND), U1.19 (AGND), U1.21 (PGND), U2.1 (PGND), U2.9 (AD), U2.20 (PGND), U2.25@0 (PGND), U2.25@1 (PGND), U2.25@2 (PGND), U2.25@3 (PGND), U2.25@4 (PGND), U2.25@5 (PGND), U2.25@6 (PGND), U3.6 (S2); also elsewhere on the board
MCU_!RESET: JP3.1; also elsewhere on the board
MPU_PWR: R5.1, U1.9 (EN)
unnamed: R18.2, U3.5 (VM)
unnamed: F1.1, P2.2
unnamed: C20.1, R17.1, U3.3 (VDD)
unnamed: R2.1, R3.2, U1.16 (FB)
unnamed: R4.1, U1.18 (EN)
unnamed: L1.2, U1.3 (SW)
unnamed: C6.1, U1.14 (SS)
unnamed: L2.2, U1.4 (SW)
unnamed: C13.1, U1.13 (SS)
unnamed: R7.2, R8.1, U1.11 (FB)
unnamed: R11.2, R12.2, R13.1, U2.14 (FOD)
unnamed: R11.1, U2.12 (ILIM)
unnamed: C17.P$1, R13.2, U2.18 (RECT)
unnamed: R9.2, U2.10 (TERM)
unnamed: C11.1, U2.5 (CLAMP1)
unnamed: C9.1, U2.6 (COMM1)
unnamed: C7.1, U2.3 (BOOT1)
unnamed: C12.1, U2.16 (CLAMP2)
unnamed: C10.1, U2.15 (COMM2)
unnamed: C8.1, U2.17 (BOOT2)
unnamed: C5.2, C8.2, C10.2, C12.2, P1.2, U2.19 (AC2)
unnamed: C3.1, C5.1, C7.2, C9.2, C11.2, U2.2 (AC1)
unnamed: C3.2, P1.1
unnamed: JP3.2, U1.15 (PG)
QI_CTRL: R14.2, U2.13 (TS/CTRL); also elsewhere on the board
VBAT: C1.P$1, C2.P$1, C15.P$1, C16.P$1, C19.P$1, C21.1, F1.2, R4.2, R5.2, R15.2, R17.2, U1.1 (VIN), U1.6 (VIN), U1.7 (AVIN), U1.20 (AVIN), U2.4 (BAT); also elsewhere on the board
VBAT_SNS: C18.1, R15.1, R16.2; also elsewhere on the board

Notes on the sheet:
Pin 20
Pin 1
Pin 7
Pin 6
Vout = Vref*(1+(R1/R2)) Vo | R1 | R2 1V2 | 274k | 294k 1V5 | 316k | 221k 1V8 | 301k | 158k 2V5 | 324k | 107k 3V3 | 309k | 71k5
VBAT_SNS = 1.43V @ VBAT = 4.295V
ADC Ref: 1.43V
Icharge = KIlim / RIlim RIlim = R1 + R2 KIlim = 314 Icharge = 234mA @ R1 = 1k2
Battery Protection Circuit
Supply Regulator
QI Charger
NTC bypass

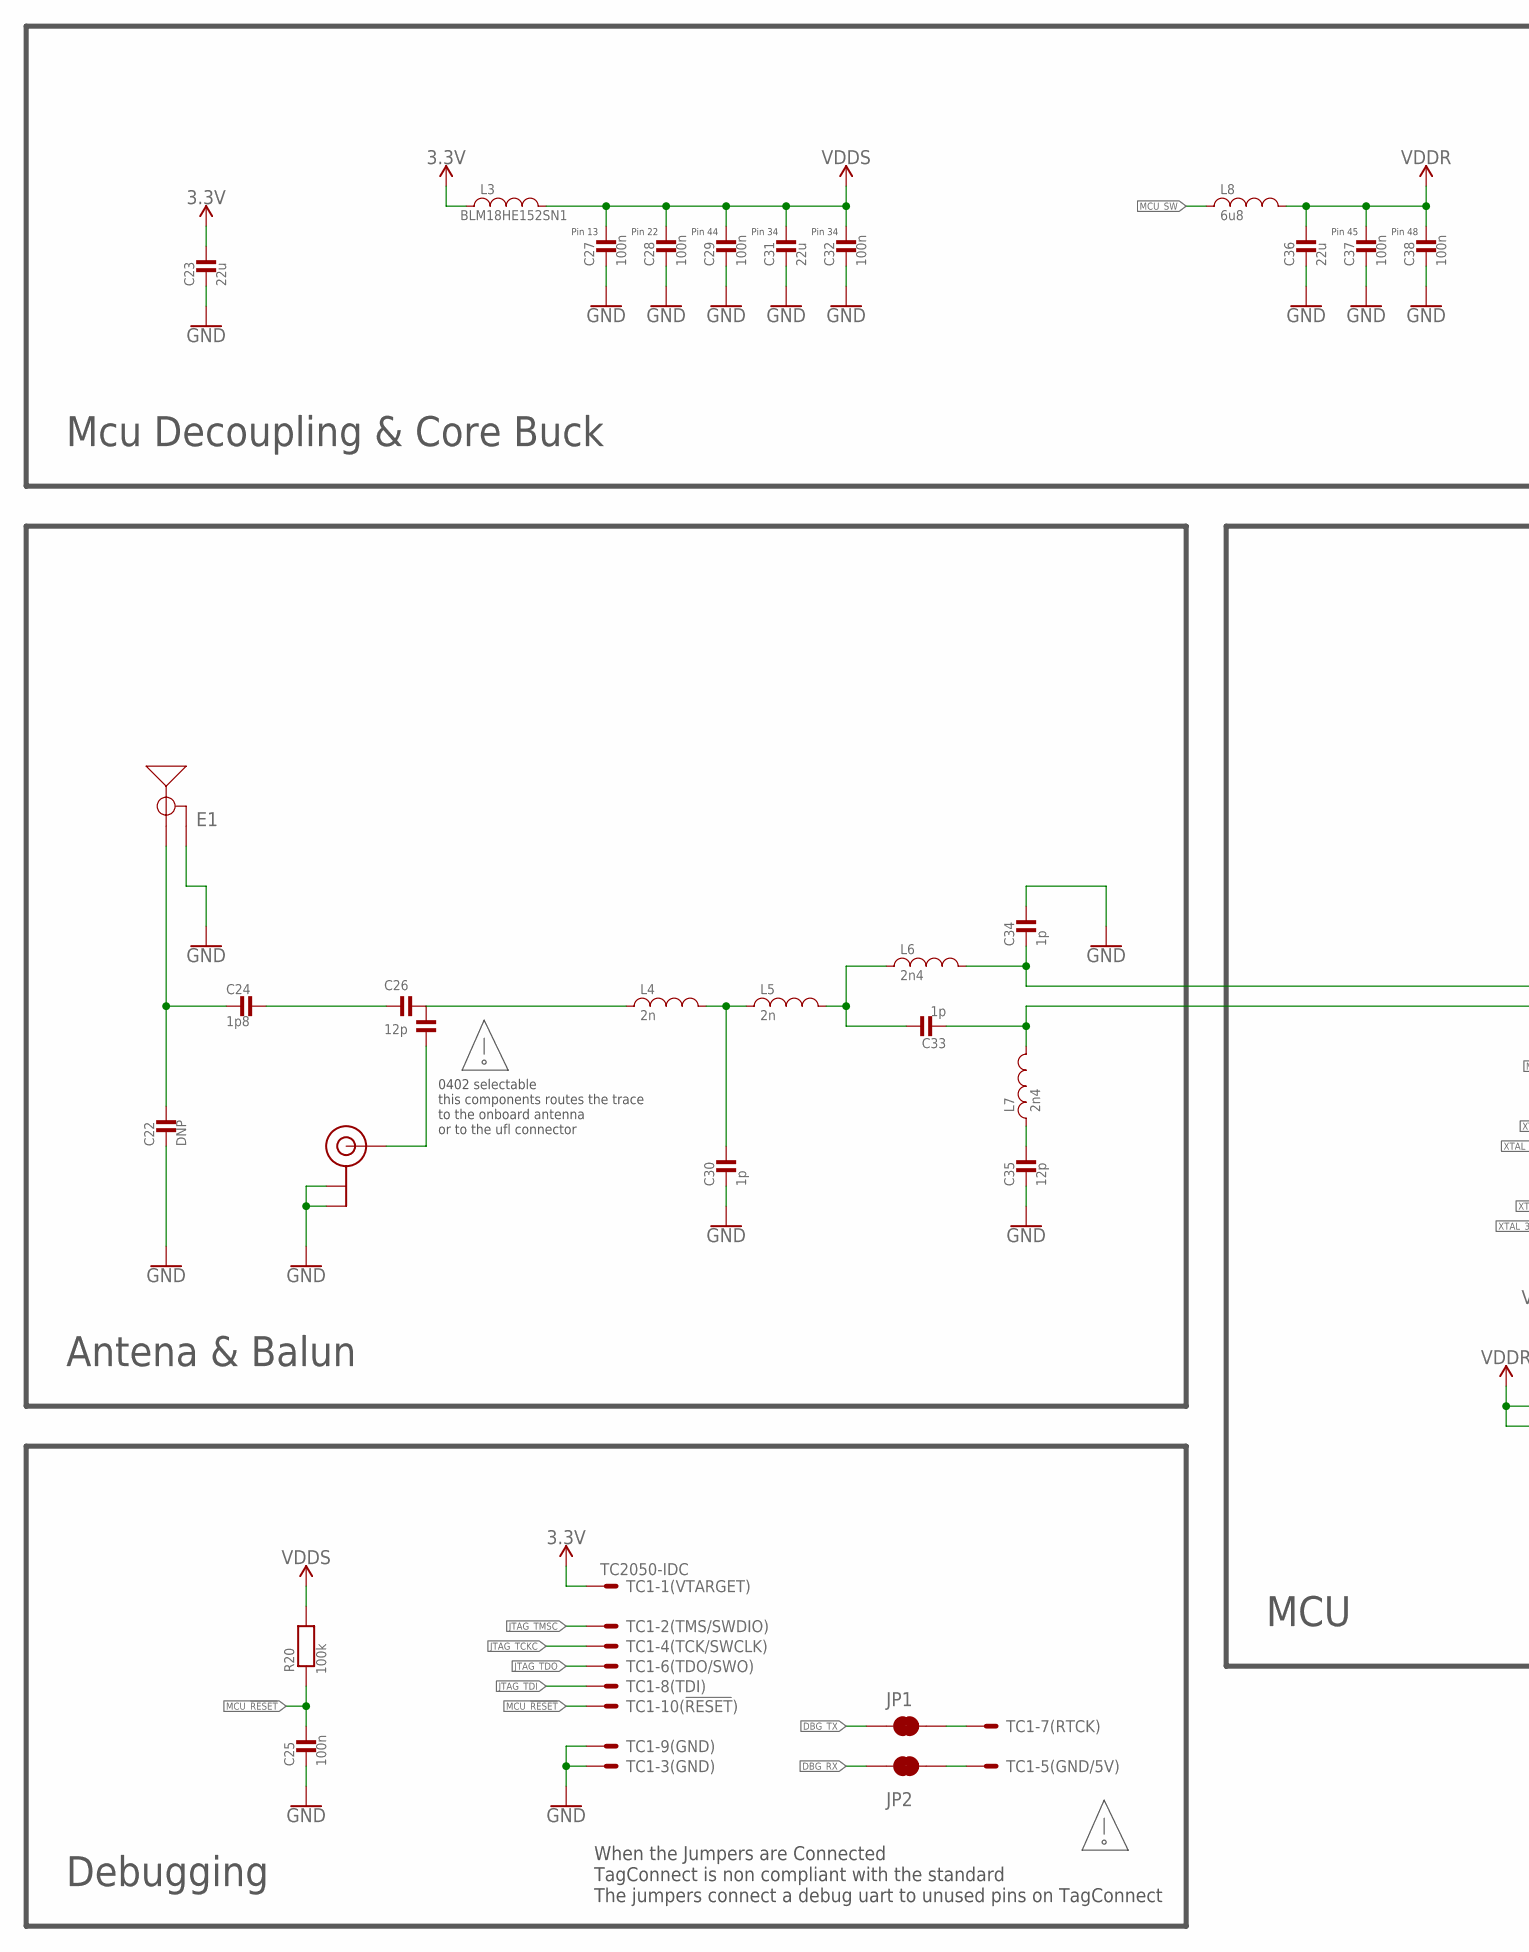
[picture p24: schematic haptic-control.sch, sheet 2, MCU, part in row 1, column 1]

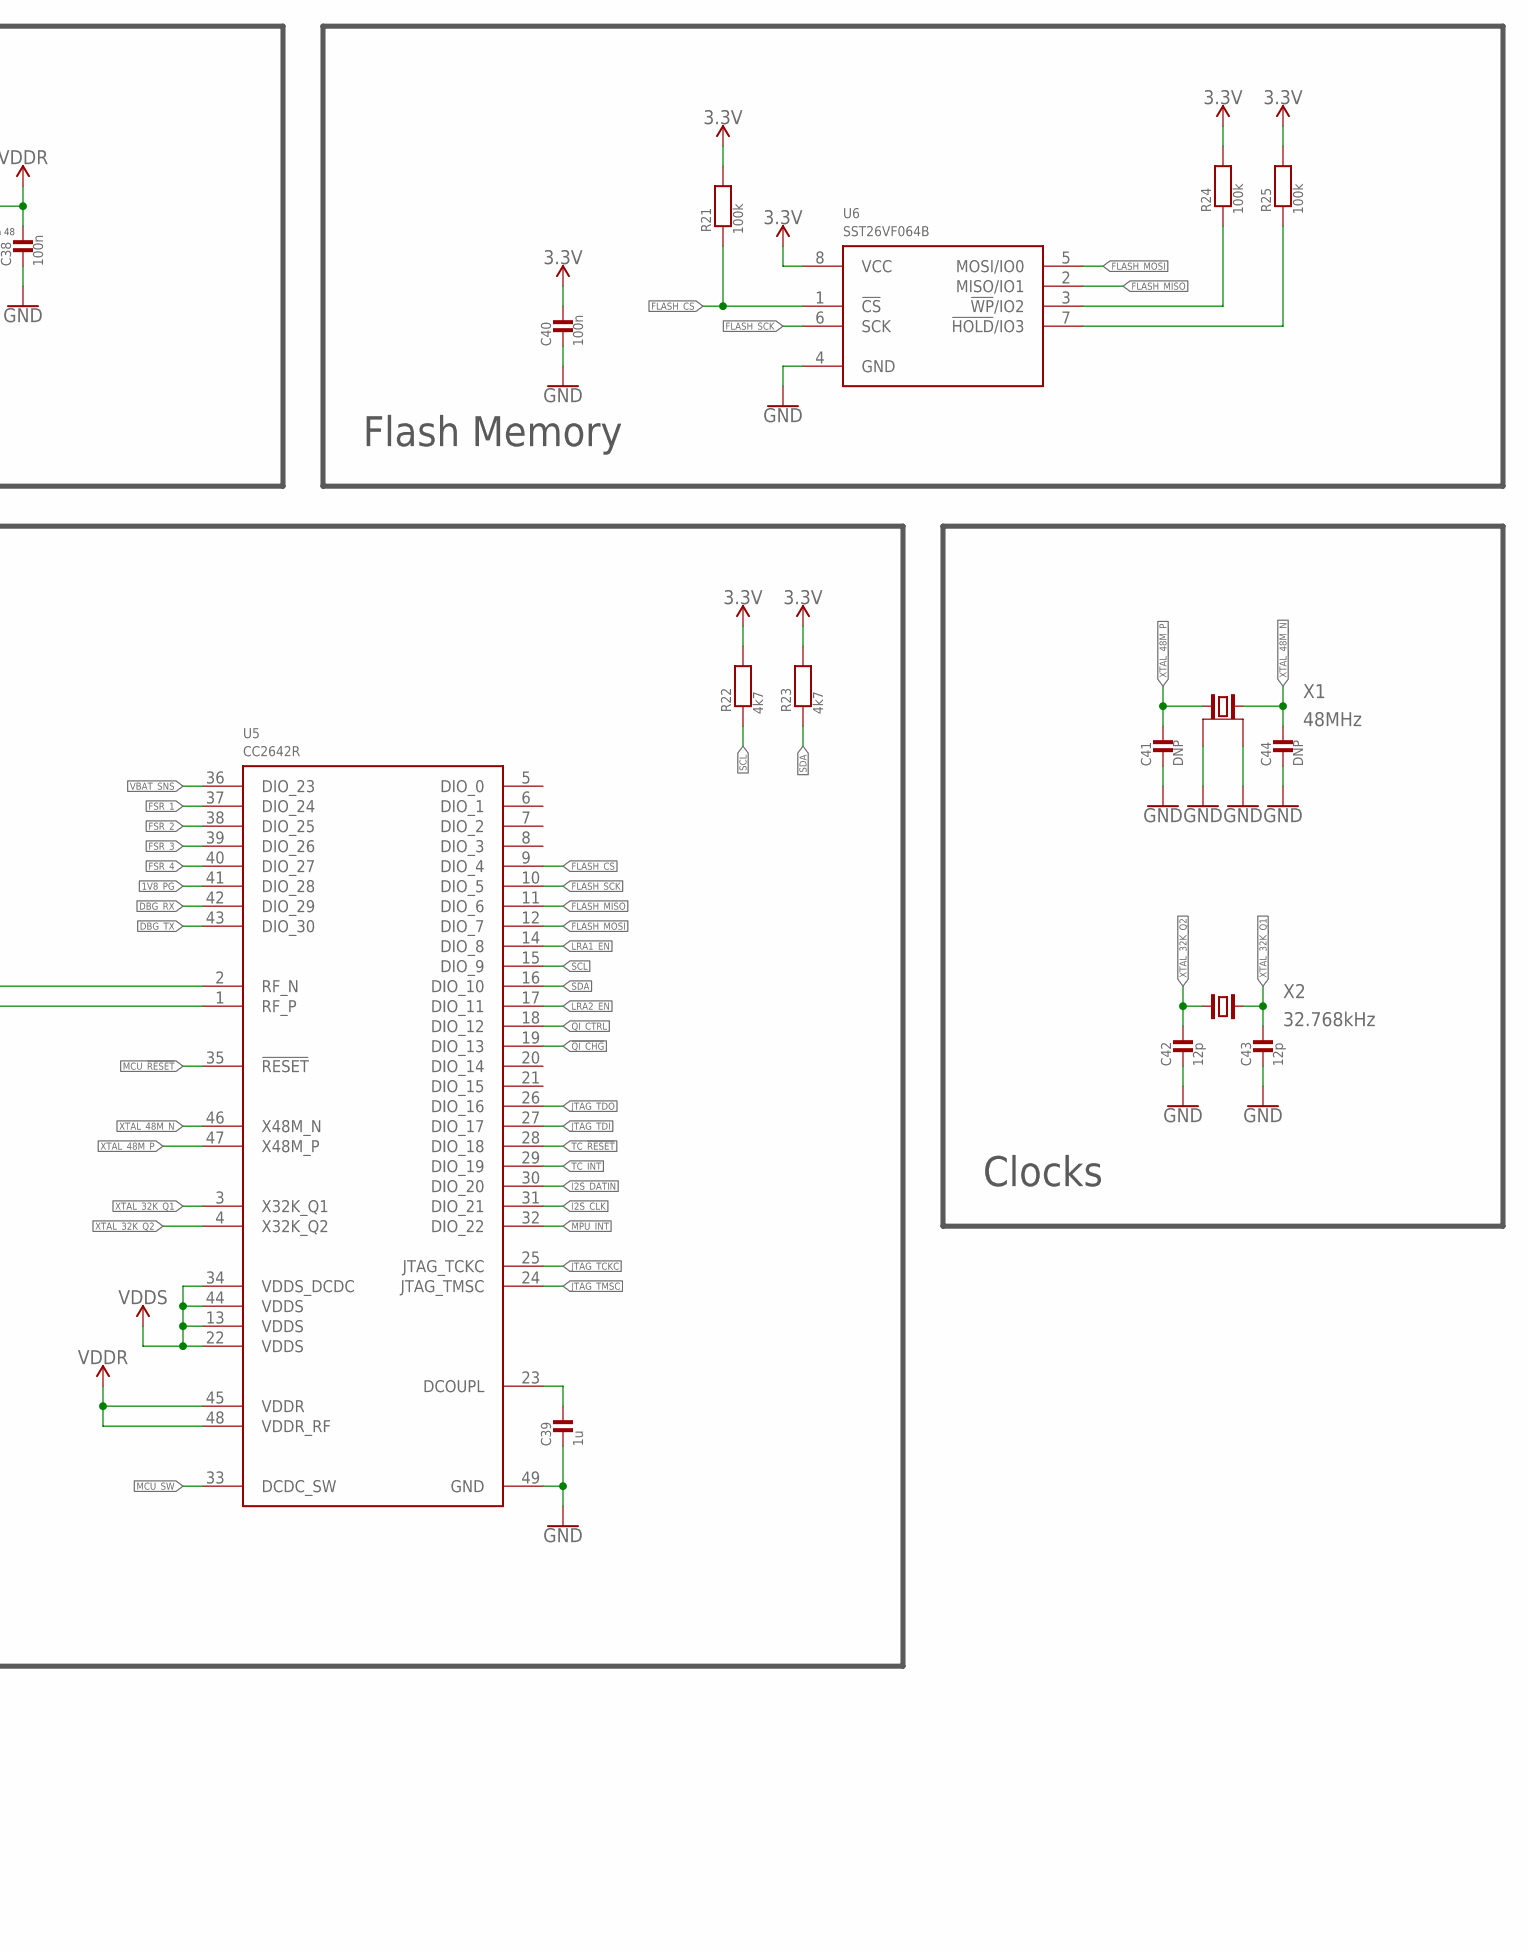
[picture p25: schematic haptic-control.sch, sheet 2, MCU, part in row 1, column 2]

Parts:
A1: U.FL
C22, C41, C44: DNP; _0402
C23, C31, C36: 22u; 0603_WAVE
C24: 1p8; _0402
C25, C27, C28, C29, C32, C37, C38, C40: 100n; _0402
C26: 12p; _0402_SEL
C30, C33, C34: 1p; _0402
C35, C42, C43: 12p; _0402
C39: 1u; 0603_WAVE
E1: 2.4GHZTRACE-15.2MM; TRACE_ANTENNA_2.4GHZ_15.2MM
JP1, JP2: JUMPER-SMT_2_NC_TRACE_SILK; SMT-JUMPER_2_NC_TRACE_SILK
L3: BLM18HE152SN1; _0603
L4, L5: 2n; _0402
L6, L7: 2n4; _0402
L8: 6u8; _0806
R20, R21, R24, R25: 100k; _0402
R22, R23: 4k7; _0402
TC1: TC2050-IDC
U5: CC2642R; QFN48
U6: SST26VF064B; WSOIC8
X1: 48MHz; 4-SMD-3225
X2: 32.768kHz; 2-SMD-3215

Connections:
1V8_PG: U5.41 (DIO_28); also elsewhere on the board
3.3V: C23.P$1, C40.1, L3.1, R21.2, R22.2, R23.2, R24.2, R25.2, TC1.1, U6.8 (VCC); also elsewhere on the board
!QI_CHG: U5.19 (DIO_13); also elsewhere on the board
DBG_RX: JP2.1, U5.42 (DIO_29)
DBG_TX: JP1.1, U5.43 (DIO_30)
FLASH_CS: R21.1, U5.9 (DIO_4), U6.1 (!CS!)
FLASH_MISO: U5.11 (DIO_6), U6.2 (MISO/IO1)
FLASH_MOSI: U5.12 (DIO_7), U6.5 (MOSI/IO0)
FLASH_SCK: U5.10 (DIO_5), U6.6 (SCK)
FSR_1: U5.37 (DIO_24); also elsewhere on the board
FSR_2: U5.38 (DIO_25); also elsewhere on the board
FSR_3: U5.39 (DIO_26); also elsewhere on the board
FSR_4: U5.40 (DIO_27); also elsewhere on the board
GND: A1.P$1 (GND), A1.P$2 (GND), C22.2, C23.P$2, C25.2, C27.2, C28.2, C29.2, C30.2, C31.P$2, C32.2, C34.1, C35.2, C36.P$2, C37.2, C38.2, C39.P$2, C40.2, C41.2, C42.2, C43.2, C44.2, E1.GND, TC1.3, TC1.9, U5.49 (GND), U6.4 (GND), X1.2 (GND), X1.4 (GND); also elsewhere on the board
I2S_CLK: U5.31 (DIO_21); also elsewhere on the board
I2S_DATIN: U5.30 (DIO_20); also elsewhere on the board
JTAG_TCKC: TC1.4, U5.25 (JTAG_TCKC)
JTAG_TDI: TC1.8, U5.27 (DIO_17)
JTAG_TDO: TC1.6, U5.26 (DIO_16)
JTAG_TMSC: TC1.2, U5.24 (JTAG_TMSC)
LRA1_EN: U5.14 (DIO_8); also elsewhere on the board
LRA2_EN: U5.17 (DIO_11); also elsewhere on the board
MCU_!RESET: C25.1, R20.1, TC1.10, U5.35 (!RESET); also elsewhere on the board
MCU_SW: L8.1, U5.33 (DCDC_SW)
MPU_INT: U5.32 (DIO_22); also elsewhere on the board
unnamed: C34.2, L6.2, U5.2 (RF_N)
unnamed: C39.P$1, U5.23 (DCOUPL)
unnamed: C33.2, L7.2, U5.1 (RF_P)
unnamed: R24.1, U6.3 (!WP!/IO2)
unnamed: R25.1, U6.7 (!HOLD!/IO3)
unnamed: C26.1 (I), L4.1
unnamed: C24.1, C26.3 (O2)
unnamed: C35.1, L7.1
unnamed: C33.1, L5.2, L6.1
unnamed: C30.1, L4.2, L5.1
unnamed: C22.1, C24.2, E1.ANT (SIGNAL)
unnamed: A1.P$3 (SIGNAL), C26.2 (O1)
unnamed: JP2.2, TC1.5
unnamed: JP1.2, TC1.7
QI_CTRL: U5.18 (DIO_12); also elsewhere on the board
SCL: R22.1, U5.15 (DIO_9); also elsewhere on the board
SDA: R23.1, U5.16 (DIO_10); also elsewhere on the board
TC_!RESET: U5.28 (DIO_18); also elsewhere on the board
TC_INT: U5.29 (DIO_19); also elsewhere on the board
VBAT_SNS: U5.36 (DIO_23); also elsewhere on the board
VDDR: C36.P$1, C37.1, C38.1, L8.2, U5.45 (VDDR), U5.48 (VDDR_RF)
VDDS: C27.1, C28.1, C29.1, C31.P$1, C32.1, L3.2, R20.2, U5.13 (VDDS), U5.22 (VDDS), U5.34 (VDDS_DCDC), U5.44 (VDDS)
XTAL_32K_Q1: C43.1, U5.3 (X32K_Q1), X2.2
XTAL_32K_Q2: C42.1, U5.4 (X32K_Q2), X2.1
XTAL_48M_N: C44.1, U5.46 (X48M_N), X1.3 (2)
XTAL_48M_P: C41.1, U5.47 (X48M_P), X1.1

Notes on the sheet:
Pin 13
Pin 22
Pin 44
Pin 34
Pin 45
Pin 48
0402 selectable this components routes the trace to the onboard antenna or to the ufl connector
Mcu Decoupling & Core Buck
Flash Memory
MCU
Clocks
Antena & Balun
Debugging
When the Jumpers are Connected TagConnect is non compliant with the standard The jumpers connect a debug uart to unused pins on TagConnect

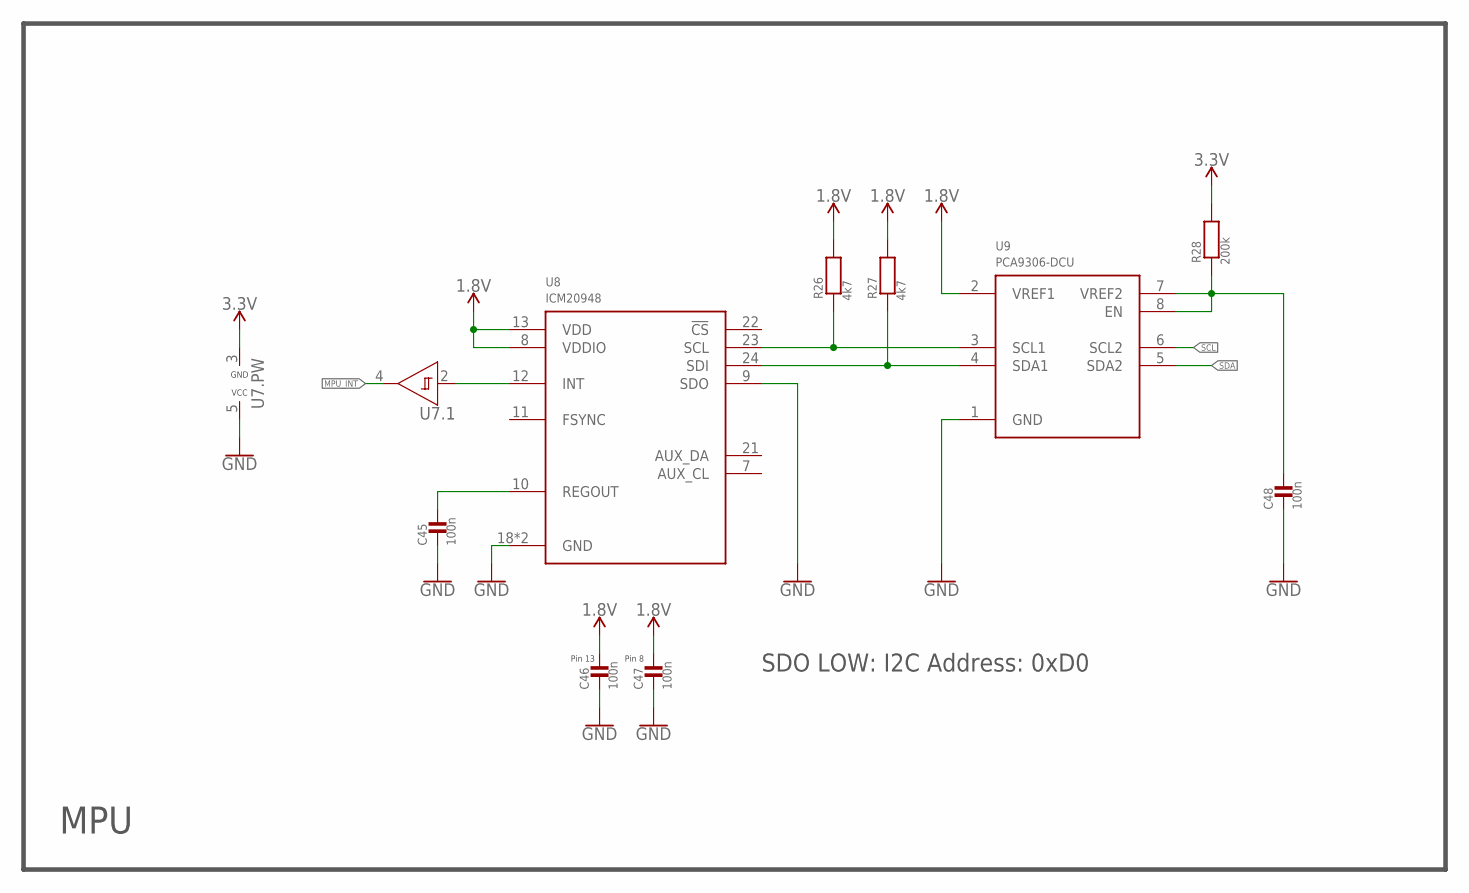
[picture p26: schematic haptic-control.sch, sheet 3, MPU]

Parts:
C45, C46, C47, C48: 100n; _0402
R26, R27: 4k7; _0402
R28: 200k; _0402
U7: 74LVC1G17; SC70-5
U8: ICM20948; QFN20
U9: PCA9306-DCU; VSSOP8

Connections:
1.8V: C46.1, C47.1, R26.2, R27.2, U8.8 (VDDIO), U8.13 (VDD), U9.2 (VREF1); also elsewhere on the board
3.3V: R28.2, U7.3 (GND); also elsewhere on the board
GND: C45.2, C46.2, C47.2, C48.2, U7.5 (VCC), U8.9 (SDO), U8.18 (GND), U8.20 (GND), U9.1 (GND); also elsewhere on the board
MPU_INT: U7.4 (Y); also elsewhere on the board
unnamed: U7.2 (A), U8.12 (INT)
unnamed: R26.1, U8.23 (SCL), U9.3 (SCL1)
unnamed: R27.1, U8.24 (SDI), U9.4 (SDA1)
unnamed: C45.1, U8.10 (REGOUT)
unnamed: C48.1, R28.1, U9.7 (VREF2), U9.8 (EN)
SCL: U9.6 (SCL2); also elsewhere on the board
SDA: U9.5 (SDA2); also elsewhere on the board

Notes on the sheet:
SDO LOW: I2C Address: 0xD0
Pin 13
Pin 8
MPU

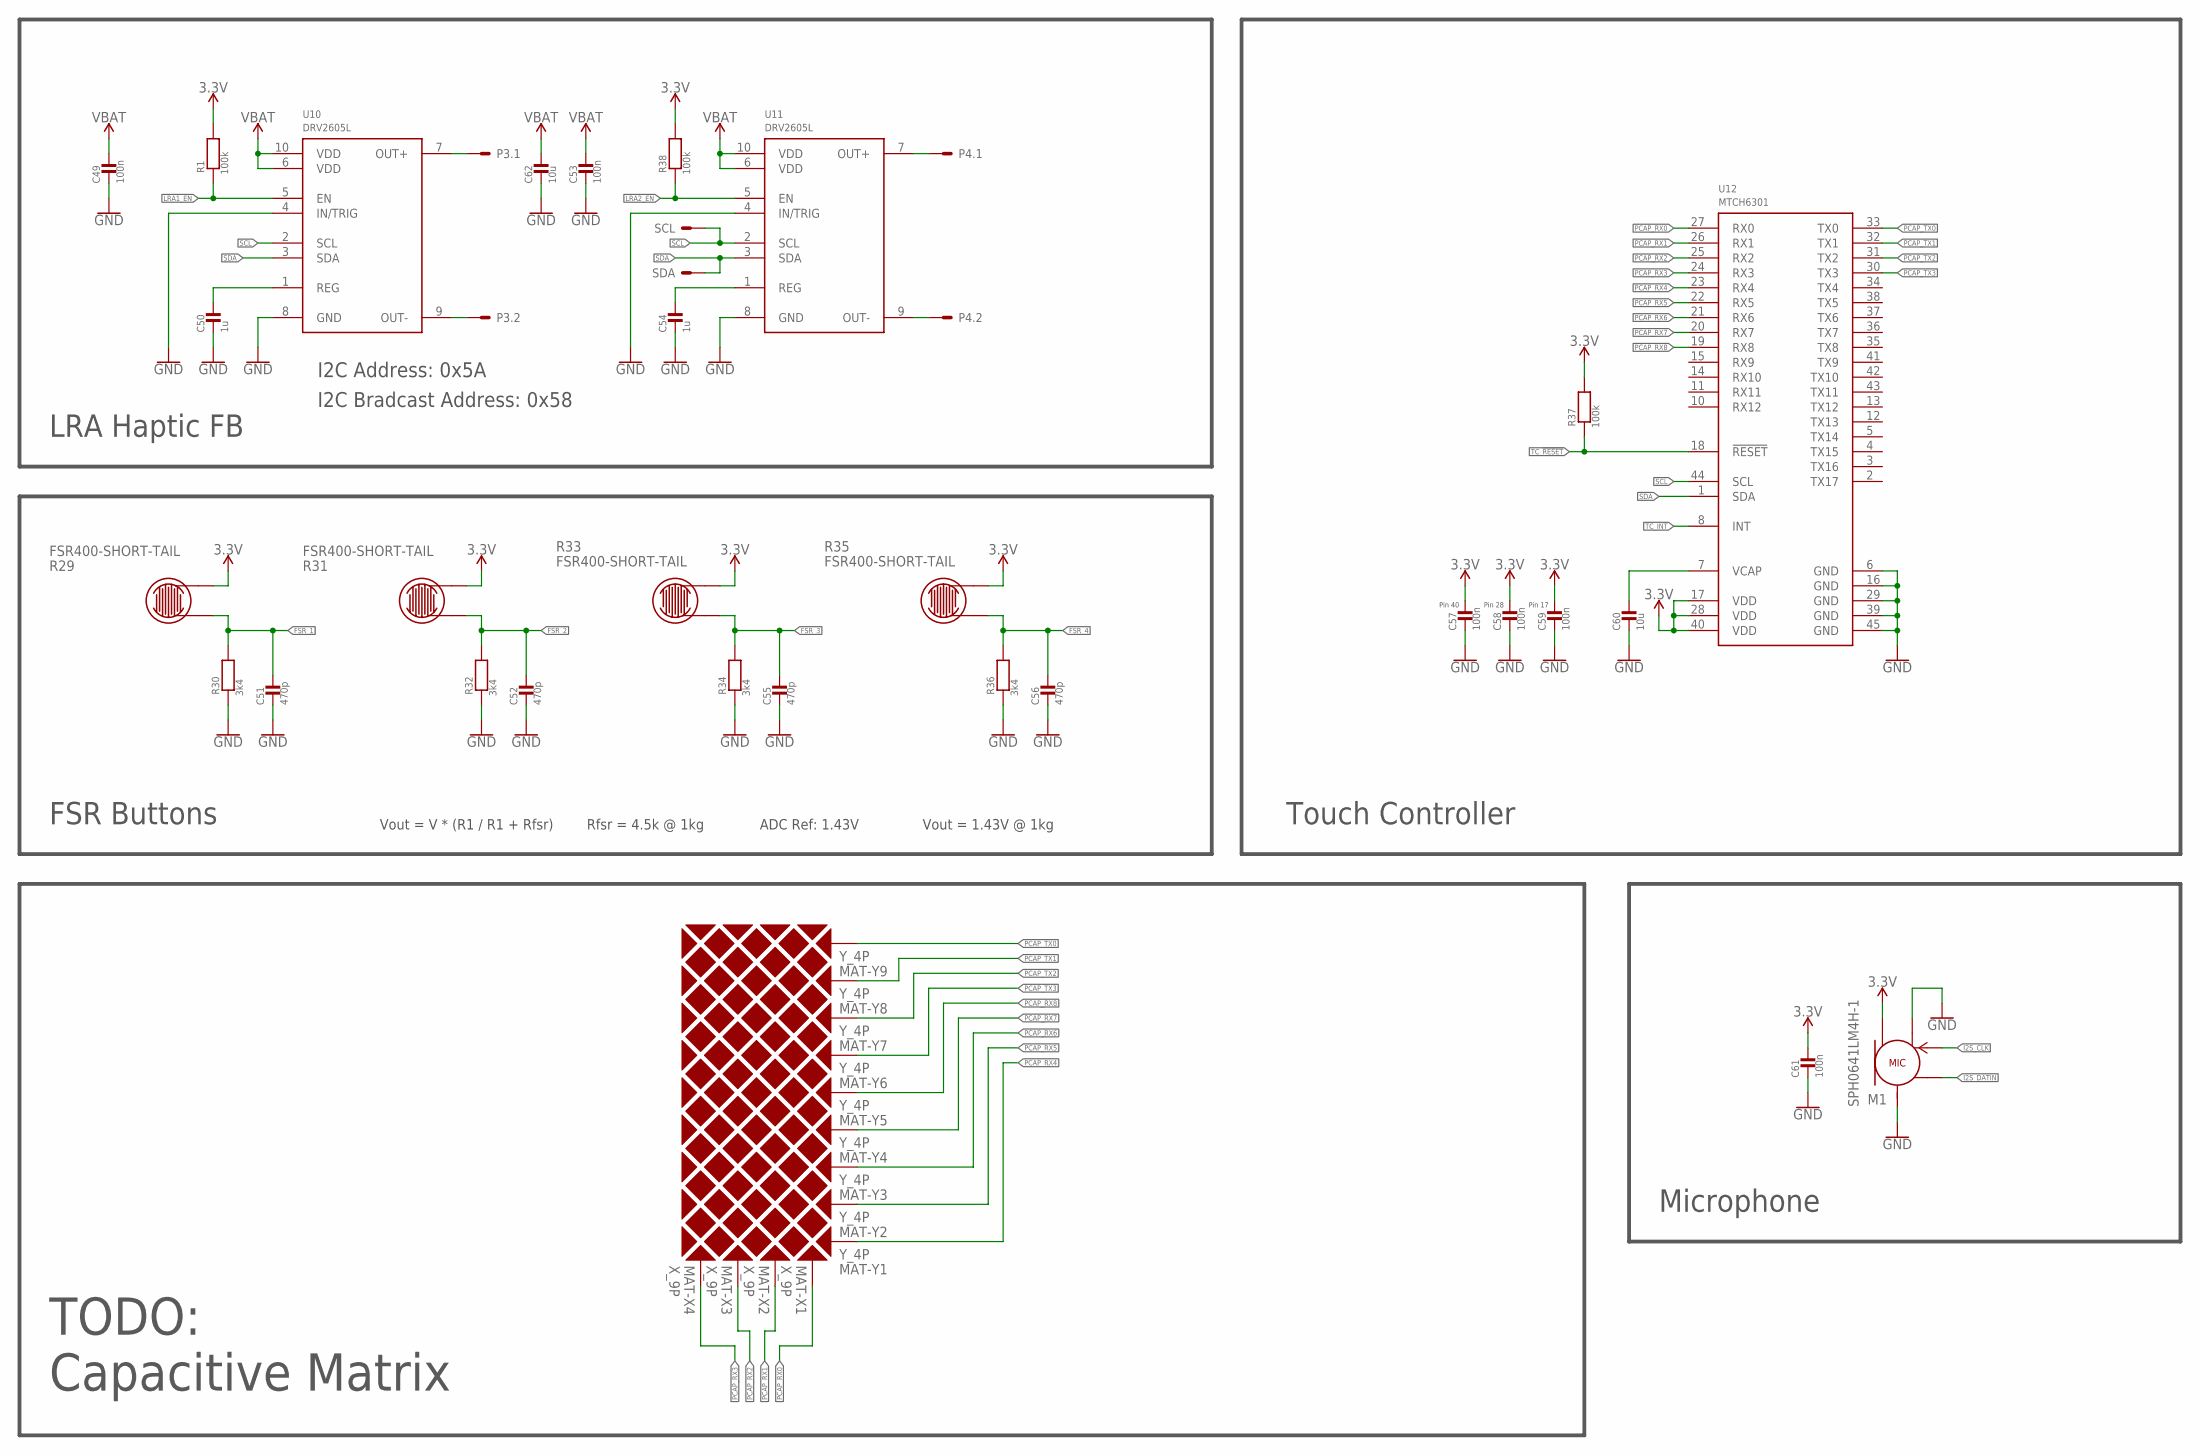
[picture p27: schematic haptic-control.sch, sheet 4, Interface]

Parts:
C49, C53, C57, C58, C59, C61: 100n; _0402
C50, C54: 1u; 0603_WAVE
C51, C52, C55, C56: 470p; _0402
C60, C62: 10u; 0603_WAVE
M1: SPH0641LM4H-1
MAT-X1, MAT-X2, MAT-X3, MAT-X4: X_9P; TOUCH_X_9P
MAT-Y1, MAT-Y2, MAT-Y3, MAT-Y4, MAT-Y5, MAT-Y6, MAT-Y7, MAT-Y8, MAT-Y9: Y_4P; TOUCH_Y_4P
P3, P4: 2P-PAD_1X3.5; PAD1X3_5MM-2P
R1, R37, R38: 100k; _0402
R29, R31, R33, R35: FSR400-SHORT-TAIL
R30, R32, R34, R36: 3k4; _0402
SCL: TEST_POINT
SDA: TEST_POINT
U10, U11: DRV2605L; VSSOP10
U12: MTCH6301; QFN44

Connections:
3.3V: C57.1, C58.1, C59.1, C61.1, M1.5 (VCC), R1.2, R29.2, R31.2, R33.1, R35.1, R37.2, R38.2, U12.17 (VDD), U12.28 (VDD), U12.40 (VDD); also elsewhere on the board
FSR_1: C51.1, R29.1, R30.2; also elsewhere on the board
FSR_2: C52.1, R31.1, R32.2; also elsewhere on the board
FSR_3: C55.1, R33.2, R34.2; also elsewhere on the board
FSR_4: C56.1, R35.2, R36.2; also elsewhere on the board
GND: C49.2, C50.P$2, C51.2, C52.2, C53.2, C54.P$2, C55.2, C56.2, C57.2, C58.2, C59.2, C60.P$2, C61.2, C62.P$2, M1.2 (SEL), M1.3 (GND), R30.1, R32.1, R34.1, R36.1, U10.4 (IN/TRIG), U10.8 (GND), U11.4 (IN/TRIG), U11.8 (GND), U12.6 (GND), U12.16 (GND), U12.29 (GND), U12.39 (GND), U12.45 (GND); also elsewhere on the board
I2S_CLK: M1.4 (CLK); also elsewhere on the board
I2S_DATIN: M1.1 (DAT); also elsewhere on the board
LRA1_EN: R1.1, U10.5 (EN); also elsewhere on the board
LRA2_EN: R38.1, U11.5 (EN); also elsewhere on the board
unnamed: C60.P$1, U12.7 (VCAP)
unnamed: P3.1, U10.7 (OUT+)
unnamed: P3.2, U10.9 (OUT-)
unnamed: P4.1, U11.7 (OUT+)
unnamed: P4.2, U11.9 (OUT-)
unnamed: C50.P$1, U10.1 (REG)
unnamed: C54.P$1, U11.1 (REG)
PCAP_RX0: MAT-X1.P$2, U12.27 (RX0)
PCAP_RX1: MAT-X2.P$2, U12.26 (RX1)
PCAP_RX2: MAT-X3.P$2, U12.25 (RX2)
PCAP_RX3: MAT-X4.P$2, U12.24 (RX3)
PCAP_RX4: MAT-Y1.P$2, MAT-Y1.P$3, MAT-Y1.P$4, MAT-Y1.P$5, MAT-Y1.P$8, U12.23 (RX4)
PCAP_RX5: MAT-Y2.P$2, MAT-Y2.P$3, MAT-Y2.P$4, MAT-Y2.P$5, MAT-Y2.P$8, U12.22 (RX5)
PCAP_RX6: MAT-Y3.P$2, MAT-Y3.P$3, MAT-Y3.P$4, MAT-Y3.P$5, MAT-Y3.P$8, U12.21 (RX6)
PCAP_RX7: MAT-Y4.P$2, MAT-Y4.P$3, MAT-Y4.P$4, MAT-Y4.P$5, MAT-Y4.P$8, U12.20 (RX7)
PCAP_RX8: MAT-Y5.P$2, MAT-Y5.P$3, MAT-Y5.P$4, MAT-Y5.P$5, MAT-Y5.P$8, U12.19 (RX8)
PCAP_TX0: MAT-Y9.P$2, MAT-Y9.P$3, MAT-Y9.P$4, MAT-Y9.P$5, MAT-Y9.P$8, U12.33 (TX0)
PCAP_TX1: MAT-Y8.P$2, MAT-Y8.P$3, MAT-Y8.P$4, MAT-Y8.P$5, MAT-Y8.P$8, U12.32 (TX1)
PCAP_TX2: MAT-Y7.P$2, MAT-Y7.P$3, MAT-Y7.P$4, MAT-Y7.P$5, MAT-Y7.P$8, U12.31 (TX2)
PCAP_TX3: MAT-Y6.P$2, MAT-Y6.P$3, MAT-Y6.P$4, MAT-Y6.P$5, MAT-Y6.P$8, U12.30 (TX3)
SCL: SCL.1, U10.2 (SCL), U11.2 (SCL), U12.44 (SCL); also elsewhere on the board
SDA: SDA.1, U10.3 (SDA), U11.3 (SDA), U12.1 (SDA); also elsewhere on the board
TC_!RESET: R37.1, U12.18 (!RESET); also elsewhere on the board
TC_INT: U12.8 (INT); also elsewhere on the board
VBAT: C49.1, C53.1, C62.P$1, U10.6 (VDD), U10.10 (VDD), U11.6 (VDD), U11.10 (VDD); also elsewhere on the board

Notes on the sheet:
TODO: Capacitive Matrix
Pin 40
Pin 28
Pin 17
Vout = V * (R1 / R1 + Rfsr)
Rfsr = 4.5k @ 1kg
ADC Ref: 1.43V
Touch Controller
Microphone
FSR Buttons
LRA Haptic FB
Vout = 1.43V @ 1kg
I2C Bradcast Address: 0x58
I2C Address: 0x5A

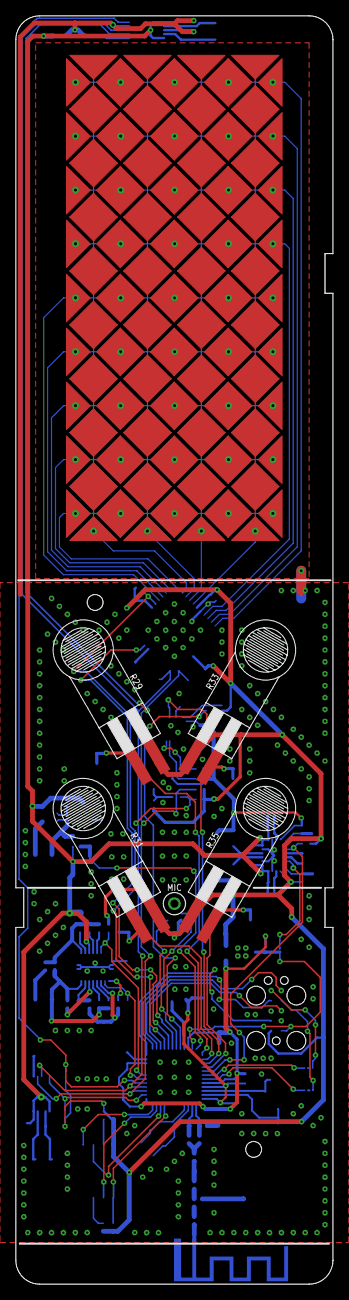
[picture p28: board haptic-control.brd from above]

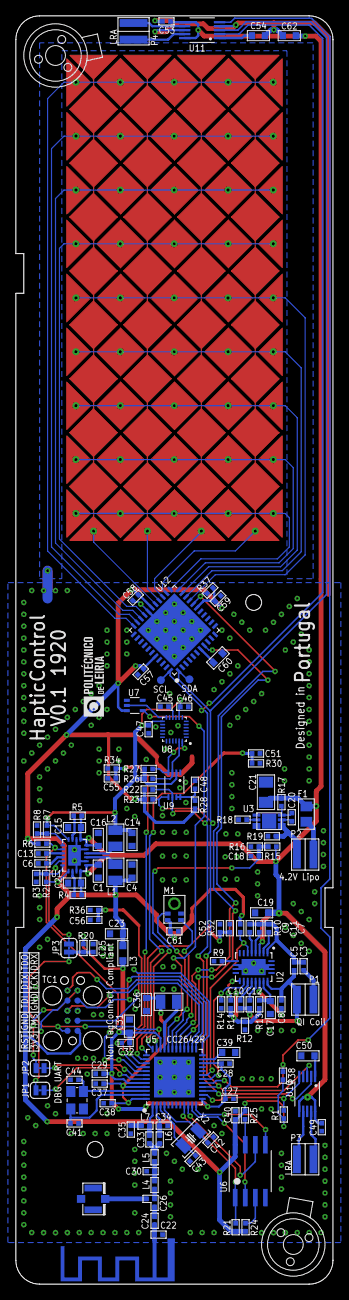
[picture p29: board haptic-control.brd from below]

Board: 2 copper layers, 40.0 x 160.0 mm, 152 parts (135 on the bottom side), 104 nets.

Other parts of the board:
U$1, U$2: G0825001
U$3: DESIGNEDINPT
