perigoso/haptic-control/(commit log)

2019-05-07 root commit
    [HapticControl.sch]
2019-05-07 initial pcb constraints, and initial sch
    [HapticControl.brd, HapticControl.sch]
2019-05-08 minor sch value modifications, and ic additions; minor pcb constraints changes
    [WCS037B.DSN, WCS037B_BOM.xlsx, WCS037B_art_param.txt, WCS037B_nc_param.txt, haptic-control.brd, haptic-control.sch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]
2019-05-08 Hand merged previous commits: Added CC26x2 reference design Added antenna matching Connected labels to touch IC Added keepouts for the antenna Added more references/info to the board and schematic
    [haptic-control.brd, haptic-control.sch]
2019-05-08 added battery and coil pads, changed mcu orientation
    [haptic-control.brd, haptic-control.sch]
2019-05-08 added LRA drivers, added FSRs
    [haptic-control.brd, haptic-control.sch]
2019-05-08 TODO: qi, mcu connect
    [haptic-control.brd, haptic-control.sch]
2019-05-09 Add QI and conect MCU
    [haptic-control.brd, haptic-control.sch]
2019-05-09 added notes to schematic
    [haptic-control.brd, haptic-control.sch]
2019-05-10 minor component placement and silkscreen changes
    [haptic-control.brd, haptic-control.sch]
2019-05-10 silkscreen experiments
    [haptic-control.brd]
2019-05-12 Add pcap touch panel
    [haptic-control.brd, haptic-control.sch]
2019-05-12 Updated FSR package with provided design dimensions
    [haptic-control.brd, haptic-control.sch]
2019-05-12 Added IPL logo
    [haptic-control.brd, haptic-control.sch]
2019-05-13 touch matrix connections
    [haptic-control.brd, haptic-control.sch]
2019-05-13 touch matrix gnd plane minor change
    [haptic-control.brd]
2019-05-13 i2c level shifter sch fix
    [haptic-control.brd, haptic-control.sch]
2019-05-13 removed hardware MPU pwr switch
    [haptic-control.brd, haptic-control.sch]
2019-05-13 Nothing to do Needs revision
    [haptic-control.brd, haptic-control.sch]
2019-05-13 minor routing changes
    [haptic-control.brd]
2019-05-14 finished routing
    [haptic-control.brd, haptic-control.sch]
2019-05-15 changed component values, created bom, changed bat prot ic
    [haptic-control-bom.xlsx, haptic-control.brd, haptic-control.sch]
2019-05-15 finished bom, exported gerbers
    [haptic-control-bom.xlsx, haptic-control.brd, haptic-control.sch]
2019-05-21 created a simplified bom for order
    [haptic-control-bom-final.xlsx, haptic-control.brd]
2019-09-19 doc update
    [haptic-control-bom.xlsx]
