perigoso/haptic-control/(notices)

Notices in the files:
pcb/haptic-control.sch:
LICENSE: Copyright © 2019 Tech4Home
